mpolci/devhub/README.md

# devhub — hub USB "intelligente" per lo sviluppo hardware

Hub USB da banco pensato per chi sviluppa dispositivi a microcontrollore collegati via USB.
Oltre alle porte downstream espone all'host un **dispositivo di controllo** (USB HID) con cui
il PC può:

- **staccare e riattaccare fisicamente** ogni porta (alimentazione VBUS e linee dati D+/D-),
  per resettare un dispositivo bloccato anche quando il reset via USB non funziona;
- **leggere lo stato** di ogni porta (abilitata/disabilitata, ciclo in corso, guasti hardware);
- **comandare un relè ausiliario** con uscita su due boccole a banana (es. per sezionare
  l'alimentazione esterna del dispositivo in prova o chiudere un contatto di reset).

## Caratteristiche previste (v1)

| Voce | Scelta v1 |
|---|---|
| Porte downstream | 4 × USB-C |
| Velocità | USB 2.0 Hi-Speed (480 Mbit/s) |
| Alimentazione per porta | 5 V, fino a 2 A sulla singola porta USB-C, circa 2,4 A totali stimati, con limitazione di corrente e sezionamento per porta |
| Sezionamento | VBUS **e** D+/D− con unico comando logico; ammessa la sequenza interna del controller |
| Ciclo di spegnimento/riaccensione porta | Ciclo temporizzato con scarica attiva, durata configurabile; default indicativo 1 s da validare, senza verifica della tensione |
| Indicazione porta | Un LED dal MCU: spento, acceso fisso, lampeggiante per guasto |
| Alimentazione hub | richiesti alimentatore USB-C 5 V / 3 A senza negoziazione PD e cavo adeguato; nessuna verifica delle CC |
| Upstream (verso il PC) | USB-C (USB 2.0) |
| Controllo | STM32G0B1 su porta interna dell'hub, interfaccia USB HID senza driver + CLI Python |
| Relè ausiliari | 1 × SPDT su due boccole a banana COM/NC, contatti max 16 V / 3 A |
| Misure | Corrente e carica erogata per porta, temperatura del controllo; nessuna tensione |
| Pannello | 5 pulsanti; 5 LED: uno per porta USB, con lampeggio guasti, e uno di host collegato |

I 3 A d'ingresso comprendono anche i consumi interni: un sovraccarico complessivo può
interrompere l'intero hub. Il ciclo non verifica elettricamente lo spegnimento e riguarda
l'alimentazione fornita dalla porta; per riavviare schede autoalimentate servono relè o reset.

Le motivazioni delle scelte (in particolare USB 2.0 invece di USB 3 e il non sezionare GND)
sono in [docs/architettura.md](docs/architettura.md).

## Struttura del repository

```
docs/        requisiti, architettura, protocollo di controllo, domande aperte
hardware/    progetto KiCad (schema, PCB, BOM)
firmware/    firmware del MCU di controllo
host/        libreria Python e strumento da riga di comando per il PC, skill per agenti AI
```

## Documenti

- [docs/requisiti.md](docs/requisiti.md) — cosa deve fare il dispositivo
- [docs/architettura.md](docs/architettura.md) — schema a blocchi, scelte progettuali, componenti candidati, bilancio di potenza
- [docs/componenti.md](docs/componenti.md) — componenti candidati, package, fornitori, classe JLCPCB
- [docs/protocollo-controllo.md](docs/protocollo-controllo.md) — bozza del protocollo HID tra PC e hub
- [docs/regole-pcb.md](docs/regole-pcb.md) — stackup, piste, USB, alimentazione, piazzamento e verifiche di produzione
- [docs/pinout-mcu.md](docs/pinout-mcu.md) — piedinatura del MCU e note per il firmware
- [docs/domande-aperte.md](docs/domande-aperte.md) — decisioni ancora da prendere

## Licenze

- **Hardware** (`hardware/`): [CERN-OHL-W 2.0](hardware/LICENSE).
- **Firmware, libreria e CLI, documentazione** (tutto il resto): [MIT](LICENSE).

## Stato

Requisiti semplificati definiti (D60–D66). Hub USB2517I-JZX, MCU STM32G0B1CEU6 in UFQFPN48
(D78), due UCS2114-1-V/LX con due bus I²C e quattro PI3USB4002A per le porte (D75), con
DigiKey come fornitore di riferimento.

Schema elettrico v0.3 allineato ai requisiti (D79–D83); PCB 100 × 100 mm a quattro strati (D84)
completo (D84–D95, vedi [hardware/README.md](hardware/README.md)). Il prototipo Rev A è
montato e funziona: corretti alcuni difetti di saldatura, nessuna modifica al PCB.

Firmware ([firmware/README.md](firmware/README.md)) e libreria Python con CLI
([host/README.md](host/README.md)) sono scritti secondo D96–D103 e il protocollo 0.1. Sul
prototipo sono verificati hub configurato via SMBus, aggiornamento via DFU attraverso il
hub, le quattro porte (accensione, spegnimento, ciclo, enumerazione di un dispositivo),
relè, LED, pulsanti, default in flash, eventi, watchdog, temperatura del MCU e corrente delle porte. Restano le misure con strumenti:
durata della scarica e del ciclo, sfasamento delle accensioni, guasti reali e ritorno di
alimentazione (D98), tempi I²C, corrente dei LED, transitori al reset e in DFU. Dopo le misure
il protocollo passerà alla versione 1.0.
