mpolci/devhub/docs/domande-aperte.md

# Decisioni e domande aperte

## Decise

Le decisioni D60–D66 e D68–D87 definiscono i requisiti correnti e prevalgono sulle parti
incompatibili delle decisioni precedenti. Lo schema v0.3 e il pinout le applicano (D79);
il PCB da 100 × 100 mm (D84) è sbrogliato.

| # | Decisione | Scelta |
|---|---|---|
| D1 | Velocità | USB 2.0 Hi-Speed |
| D2 | Sezionamento | VBUS + D+/D- a stato solido; GND mai interrotta |
| D3 | Relè ausiliari | 2 canali, contatti max 16 V / 3 A, bobina 5 V; relè SPDT da 5–10 A, sul pannello **COM e NC** (2 boccole per canale): linea normalmente collegata, bobina eccitata solo per staccare; NO su ponticello a saldare interno |
| D4 | Misura corrente per porta | sì |
| D5 | Pulsanti fisici per porta | sì, uno per porta, più LED |
| D6 | MCU | STM32: **STM32G0B1RET6** (LQFP-64, USB FS + UCPD) |
| D7 | PCB e assemblaggio | JLCPCB 4 strati; **strategia C**: montaggio tutto a mano con piastra riscaldante e aria calda (stencil per i QFN), componenti da un unico fornitore; nessun tipo extended |
| D8 | Alimentazione | USB-C a **5 V / 3 A senza PD**; ~2,3 A totali per le porte, 2 A su una singola porta; budget letto da CC e gestito dal firmware con le misure di corrente |
| D9 | Upstream verso il PC | connettore USB-C |
| D10 | Strumento host | libreria Python generica (multipiattaforma via `hidapi`) + CLI per macOS costruita sopra |
| D11 | Fornitore | si decide alla fine, a componenti finalizzati |
| D12 | Licenze | hardware **CERN-OHL-W 2.0**; firmware, libreria e CLI **MIT** |
| D13 | VID/PID USB | VID 0x1209 (pid.codes) con PID di test durante lo sviluppo; PID definitivo da richiedere a pid.codes alla pubblicazione |
| D14 | Porta hub di scorta (DS7) — superata da D76 | Header eliminato; nessuna uscita USB di scorta. |
| D15 | Scatola | stampata in 3D su misura; tutti i connettori saldati sul PCB, boccole a banana in versione da PCB; connettori sui due lati corti (banco: porte, pulsanti, boccole; retro: upstream e alimentazione); pulsanti e LED  sulla faccia superiore del PCB (D42) |
| D16 | Reset del hub | supervisore **MCP120T-300** open-drain su RESET_N con pull-up, in wired-OR con il MCU (open-drain, ora su PF1: D34): il hub non dipende dal firmware e resta acceso durante reset e DFU del MCU |
| D17 | Regolatore 3,3 V | LDO **AP7361C-33E** (1 A, SOT-223) al posto dell'AP2112K in SOT-23-5 |
| D18 | Connettori USB | orizzontali (angolo retto, montati sopra il PCB): **GCT USB4105-GF-A** per tutti e sei gli USB-C (16 pin USB 2.0, 5 A, guscio con linguette passanti), **Kycon KUSBX-AS1N-B** passante per l'USB-A; scartati i modelli ruotati di 90° (rari e meno robusti) |
| D19 | Quarzo del hub | YXC **X322524MOB4SI** (24 MHz, 3225, C_L 12 pF, il più economico e con più disponibilità), C22/C23 = 15 pF C0G |
| D20 | Condensatori d'ingresso | invariati (2 × 220 µF + 2 × 10 µF): il picco all'inserzione lo elimina l'avvio dolce dell'eFuse |
| D21 | Protezione d'ingresso — soglie precisate da D85 | eFuse **TPS259470A**: stacca sopra 5,84 V e sotto 4,0 V, limite 3,5 A, avvio dolce ~5 ms, FLT al MCU (PB1) |
| D22 | Switch dati delle porte | **PI3USB4002A** al posto del TS3USB30E: il lato connettore regge 24 V e si apre sopra 4,75 V (corti D+/D- su VBUS) |
| D23 | Fornitore — precisata da D77 | DigiKey è il fornitore di riferimento; alternative in `componenti.md`. |
| D24 | LED per porta | due: alimentata (verde) e fault (rosso); lo stato delle linee dati non ha un LED |
| D25 | TVS | sull'ingresso **SMAJ20A** (non conduce fino a 20 V, l'eFuse gestisce le sovratensioni); sulle VBUS delle porte nessuna TVS e nessuna piazzola: bastano i 22 µF + 100 nF |
| D26 | Pulsanti | uno per porta e uno per relè (SW1/SW2 aggiunti); ogni pressione alterna lo stato: porta accesa/spenta con alimentazione e dati sempre insieme, linea del relè collegata/staccata (RF-17) |
| D27 | ESD delle porte downstream | tolte le USBLC6-2SC6 (D101-D501): il loro pin VBUS sulla VBUS commutata faceva passare corrente dai dati all'alimentazione della porta e portava le sovratensioni dei dati verso la 5 V; la protezione ESD è quella integrata nel PI3USB4002A (10 kV IEC, invece dei 15 kV dell'USBLC6). Revisione 02, rilievo R02-01 |
| D28 | Comando delle porte | alimentazione e dati sempre insieme (RF-3 cambiato): niente comandi separati per VBUS e dati né da PC né da pulsante; restano due interruttori distinti per poter rispettare la sequenza |
| D29 | Rilevamento dell'inserimento sulle porte USB-C | non fatto (opzione C, revisione 02, R02-02): VBUS presente appena la porta è accesa; il firmware non accende una porta con tensione già presente e spegne una porta che riceve corrente, con LED rosso e avviso al PC. Scartati un controller USB-C per porta (TPS25810) e la lettura delle CC dal MCU (richiedeva tutti i pin liberi e lasciava senza alimentazione le schede prive di resistenze CC) |
| D30 | Corrente annunciata dalle porte USB-C | standard USB (Rp 56 kΩ, 500 mA) al posto di 1,5 A (revisione 02, R02-03): annuncio coerente con il budget; la porta non lo impone, chi lo ignora assorbe fino a ~2,3 A |
| D31 | Limiti della protezione d'ingresso | protezione garantita in continuo fino a 20 V; sopra ~23 V la SMAJ20A si sacrifica e l'INA3221 (26 V) non è garantito (superato da D40: l'INA3221 non è più sulla catena d'ingresso); TVS invariata, codice fissato in `componenti.md` (revisione 02, R02-04) |
| D32 | Alimentazione della logica | RF-16 eliminato: hub e MCU solo dall'alimentatore, tolto D3 (ORing dalla VBUS upstream), D2 resta per la dissipazione dell'LDO; VBUS_DET e VSYS_ADC su pin FT (PA6, PA7; poi PB2, PB0 con D34) perché il partitore VBUS_DET ha tensione anche a MCU spento; con sovratensione o sottotensione d'ingresso si spegne tutto senza segnalazione al PC; hub funzionante dal solo PC rimandato come variante futura (revisione 02, R02-05) |
| D33 | Driver dei relè | **ULN2003V12** al posto del ULN2003A (stessa piedinatura, uscite MOSFET), tre canali in parallelo per relè: caduta ~0,2 V invece di 0,9–1,1 V, scatto garantito fino a 5V_SYS = 4,5 V e 40 °C; alternativa 2× AO3400A (revisione 02, R02-06) |
| D34 | Pin del MCU, UCPD e bootloader | HUB_RST_N da PA8 (pin CC dell'UCPD, pull-down Rd dopo ogni reset) a PF1; spostati VBUS_DET (PB2), VSYS_ADC (PB0), INA_ALERT (PC12), RLY1/RLY2 (PA4/PA5), EN_P4 (PA7) perché nel bootloader ST relè e porte restino a riposo e il hub funzioni; DBCC dell'UCPD1 a massa con 10 kΩ (R48, R49); il firmware stacca le Rd con UCPDx_STROBE; DFU da provare sul prototipo (revisione 02, R02-07) |
| D35 | Reset del solo hub | gestito dal firmware senza modifiche hardware: lettura di HUB_RST_N ogni ≤10 ms, presa del reset con PF1, rilascio con I2C fermo e configurazione SMBus dopo il rilascio effettivo di U12; brownout reset del MCU non usato perché lascerebbe una finestra 2,8-3,0 V (revisione 02, R02-08) |
| D36 | Accuratezza della misura di corrente | shunt 20 mΩ invariati; RF-6 specifica ±(2 mA + 1,3 % della lettura) (superato da D55: 5 %) con l'azzeramento dell'offset a porta spenta (firmware); collegamenti Kelvin sugli shunt nel PCB; 50 mΩ scartati per la caduta sulla VBUS (revisione 02, R02-09) |
| D37 | Durata della scarica VBUS | non più 100 ms fissi: DIS on finché la VBUS misurata scende sotto 0,8 V (vSafe0V) più ~50 ms, timeout 1 s con porta spenta e PORT_FAULT "sorgente esterna" (protegge anche la 100 Ω, al massimo con 5 V); `off_ms` di CYCLE_PORT contato da VBUS sotto 0,8 V; stessa soglia per il controllo prima dell'accensione (revisione 02, R02-10) |
| D38 | Pilotaggio dei LED | tolti i due 74HC595 (con C90, C91 e il pull-up di /OE R94): verde di ogni porta sull'EN, LED dei relè sui comandi RLY, "acceso" sulla 3,3 V, rossi e host su 6 GPIO (PB3, PB4, PB5, PD0, PB15, PA8) spenti in DFU; i verdi non lampeggiano più, i casi si distinguono con lampeggi del rosso; con il PCB a 4 strati le piste in più non pesano |
| D39 | Condensatori dei pulsanti | tenuti i 100 nF sui 7 pulsanti: toglierli fa risparmiare solo 7 posizionamenti e riduce il margine contro disturbi e scariche sulle linee che arrivano al pannello; il debounce resta in firmware |
| D40 | Shunt d'ingresso dopo l'eFuse | R5 tra l'uscita dell'eFuse e tutti i carichi: il canale 3 dell'INA3221 misura corrente totale e 5V_SYS e non è più esposto alla tensione dell'alimentatore; tolti R7 e C7 e il partitore VSYS_ADC (PB0 libero); LOCAL_PWR con pull-up R26 da 10 kΩ verso la 3,3 V; persa solo la tensione a monte dell'eFuse, inutile dopo D32 |
| D41 | Condensatore sul reset del hub | C24 (100 nF su HUB_RST_N) DNP: il ritardo di 150-700 ms è interno al MCP120 e Microchip non mette condensatori sull'uscita; resta la piazzola per montarlo (anche 1 nF) se compaiono reset spuri; evita anche il picco di scarica su PF1 |
| D42 | PCB e vincoli della scatola | PCB 169 × 85 mm (172,5 × 85 con D59), angoli raggiati R3, 4 fori M3 a 4,5 mm dai bordi; **faccia superiore: solo LED e pulsanti** (premuti e visti dal coperchio), **faccia inferiore: tutto il resto**, connettori compresi; fronte da sinistra (vista dall'alto): porte 1-4 USB-C a passo 15 mm, USB-A a 20 mm dalla porta 4, poi le boccole a coppie (COM/NC dello stesso relè) a 17 mm tra le boccole di una coppia e 20 mm tra USB-A e prima coppia e tra le due coppie; facce dei connettori USB a filo del bordo del PCB, che sta sulla faccia interna della parete frontale; boccole a filo della faccia esterna: la S16N-PC non ha filetto né dado, davanti al corpo c'è un manicotto isolante fisso di 14,35 mm che attraversa il pannello, quindi il corpo è 11,85 mm dentro il PCB e la parete va ispessita intorno alle boccole fino a 14,35 mm (con parete da 2,5 mm); LED e pulsanti come in D43; retro: upstream J2 a 40 mm e alimentazione J1 a 110 mm dal bordo sinistro (disposizione del fronte e del retro superata da D51; passi, distanze e vincoli meccanici invariati) |
| D43 | LED e pulsanti sulla faccia superiore | pulsanti **SMD C&K PTS645SL70SMTR92 LFS** (6×6, attuatore 7 mm, footprint `SW_SPST_PTS645Sx43SMTR92` comune alla serie) al posto dei THT da 13 mm, in fila a 36 mm dal bordo frontale, in asse con ogni porta e al centro di ogni coppia di boccole; LED di ogni porta in colonna, verde a 2 mm e rosso a 6 mm dal bordo frontale; LED dei relè (D90, D91) verdi invece che gialli, nella fila dei verdi; LED acceso (D92) e host (D93) in colonna all'estrema destra (u = 165,5 mm con D59), centrati sulla fila dei pulsanti |
| D44 | Stackup PCB | **JLC04161H-7628**, come nel documento delle regole di prog-board-native: 4 layer, 1,6 mm nominali, rame esterno 1 oz e interno 0,5 oz; prepreg 0,2104 mm per lato e core 1,065 mm. Il modello generico salvato nel PCB di riferimento non si applica. Geometria USB confermata dal calcolatore JLCPCB: 90 Ω differenziali, larghezza 0,2474 mm / gap 0,1519 mm, coppia non coplanare con solder mask su B.Cu e riferimento GND In2.Cu; controllo e tolleranza produttivi da confermare nell’ordine; dettagli in [regole-pcb.md](regole-pcb.md). |
| D45 | Componenti da magazzino e codici fornitore — C3/C4 superati da D86 | si usano i pezzi a magazzino comprati da LCSC, TME, Mouser o DigiKey (non AliExpress), anche cambiando package ma senza passare a 0402 (salvo i 100 nF di U2 e U12, D58, e quelli del MCU U3, D88): C106-C506 in 0603, F1 PTC MF-MSMF050-2 in 1812, C3/C4 Man Yue EGT 220 µF 25 V D6,3 passo 2,5 mm, C505 Panasonic EEE-FK1C101P 6,3 × 5,8 mm; D2 = Diodes B340A-13-F; campi `warehouse`, `lcsc`, `mouser`, `digikey` su tutti i simboli; costi in [confronto-costi.md](confronto-costi.md) |
| D46 | Piazzamento condensatori dei pulsanti | i sette condensatori da 100 nF vanno sulla faccia inferiore vicino ai rispettivi GPIO del MCU, con pista condensatore → pin corta e via GND presso il pad di massa; linee dei pulsanti sopra GND e lontane da bobine e loop di potenza. Il debounce resta in firmware (D39); dettagli in [regole-pcb.md](regole-pcb.md). |
| D47 | Piazzamento dei componenti di supporto | integrati piazzati insieme a disaccoppiamenti, REF, bias e reti di regolazione; capacità VBUS presso le porte, filtri CC R3/C1 e R4/C2 presso il MCU, scarica raggruppata per porta e separazione termica dei circuiti di misura. Distanza connettore–PI3USB4002A da verificare conciliando ESD e integrità USB; per U13 valgono anche le prescrizioni specifiche TPS25947, con collegamenti locali IN/OUT verificati per almeno 6 A e capacità parassita ILM < 50 pF; regole operative in [regole-pcb.md](regole-pcb.md). |
| D48 | Bypass sull'uscita dell'eFuse | C7, 1 µF 25 V X7R 0603 (lo stesso di C106, magazzino ID 240), da 5V_EFUSE a GND presso il pin OUT di U13, prima dello shunt R5: è il ceramico ≥ 1 µF presso OUT richiesto dal datasheet TPS25947 (§8.3.1 e §8.4.1); C3–C6 sono dopo R5 e non lo sostituiscono. Nessuno Schottky di clamp su OUT: l'uscita non va a un connettore né a carichi induttivi, ma solo ai condensatori di riserva sulla scheda attraverso R5 e ai load switch delle porte, che limitano per conto loro; per lo stesso motivo non serve la TVS OUT–IN prevista per le uscite USB-C |
| D49 | Nomi delle coppie USB | suffissi `DP` / `DN`, con numero finale ammesso, perché KiCad riconosca le coppie differenziali (router, gap, skew): `HUB_DP1…5` / `HUB_DN1…5`, `USB_MCU_DP` / `USB_MCU_DN`, `USBUP_DP` / `USBUP_DN`, `SPARE_DP` / `SPARE_DN`, lato connettore `CONN_DP` / `CONN_DN` nei fogli porta e `UP_CONN_DP` / `UP_CONN_DN` sull'upstream; i nomi dei pin dei simboli restano quelli del costruttore |
| D50 | Via termiche del USB2517 | impronta di progetto `QFN-64-1EP_9x9mm_P0.5mm_EP4.7x4.7mm_ThermalVias_0.3mm`, derivata da quella KiCad: 16 via 0,60/0,30 (erano 0,50/0,20), le esterne a ±2,05 mm per restare nel pad esposto da 4,7 mm, nei valori di Microchip AN18.15 (foro 0,25–0,30, pad 0,5–0,6, passo 0,8–1,5, almeno 16 via). Via **aperte su entrambi i lati**, sul lato opposto con apertura della maschera uguale al pad (1:1, ammessa da JLCPCB): nessuna richiesta particolare al fabbricante. Le via "encroached" preferite da Microchip (apertura = foro + 0,06) sarebbero aperture più piccole del pad, che JLCPCB allarga se non lo si chiede nell'ordine; le via coperte intrappolano gas e quelle riempite si pagano a parte sui 4 strati. Rischio accettato per il prototipo: un po' di stagno può scendere nei fori e ridurre la saldatura sotto U2, che dissipa fino a ~1,5 W; da verificare con la temperatura di U2 a 7 porte Hi-Speed. **Per la produzione** l'apertura sul lato opposto va ristretta a via "encroached" (diametro foro + 0,06, cioè 0,36 con `solder_mask_margin` −0,12, Figura 3 di AN18.15) e l'ordine JLCPCB deve contenere la nota nel "PCB Remark" e la conferma dei file di produzione, come descritto in [regole-pcb.md](regole-pcb.md#verifiche-prima-della-produzione) |
| D51 | Disposizione dei connettori | fronte specchiato rispetto a D42 (vista dall'alto, da sinistra): boccole COM1, NC1, COM2, NC2 a u = 17,5, 34,5, 54,5, 71,5 mm, USB-A (porta 5) a u = 91,5 mm, USB-C porte 4, 3, 2, 1 a u = 111,5, 126,5, 141,5, 156,5 mm (u dal bordo sinistro dopo D59), con la porta 1 all'estrema destra; passi e distanze di D42 invariati. Retro: alimentazione J1 a u = 53,5 mm (sinistra), upstream J2 a u = 138,5 mm (destra). Il USB2517 è sulla faccia inferiore: visto dall'alto le sue porte 1→5 girano in senso orario e le coppie arrivano sul fronte da destra verso sinistra, quindi con la porta 1 a destra le cinque coppie non si incrociano e restano su B.Cu senza via; J2 sopra il hub accorcia l'upstream. LED e pulsanti seguono la propria porta o coppia di boccole come in D43, D92/D93 restano a u = 165,5 mm |
| D52 | Polarità delle coppie USB fra componenti sulla faccia inferiore — realizzazione dell'incrocio superata da D94 | canali dell'USBLC6 D20 scambiati: UP_CONN_DN/USBUP_DN su I/O1 (pin 1/6), UP_CONN_DP/USBUP_DP su I/O2 (pin 3/4); con l'assegnazione precedente D+ e D− si sarebbero incrociati fra J2 e D20, il componente è simmetrico. La coppia Full-Speed hub → MCU (USB_MCU_DP/DN) si incrocia comunque, perché i due integrati specchiati numerano i pin nello stesso verso: USB_MCU_DN passa su F.Cu con due via e USB_MCU_DP gira attorno alle via su B.Cu; ammesso a 12 Mbit/s, da non replicare sulle coppie Hi-Speed |
| D53 | VBUS_DET del hub a logica spenta | partitore R22/R23 100 kΩ + 100 kΩ dalla VBUS upstream, senza altri componenti: è il circuito raccomandato dalla *USB2517 Hardware Design Checklist* di Microchip (sezione 5.1), che prevede esplicitamente la VBUS presente prima che l'hub sia alimentato e chiede solo un'impedenza alta per limitare la corrente nel pin (qualche decina di µA con 100 kΩ). Il datasheet (tabella 8.2) indica come limite di funzionamento degli I/O la 3,3 V + 0,5 V quando l'alimentazione è sotto 3,0 V: si segue la checklist, più specifica per questo pin. Scartato lo Schottky verso la 3,3 V proposto con la revisione 03 (R03-02): componente in più per un caso già coperto dal costruttore. La VBUS upstream ha 4,7 µF (C20), sotto i 10 µF massimi della checklist |
| D54 | Corrente della porta USB-A | il connettore Kycon KUSBX-AS1N-B (J501) è da 1,5 A, come quasi tutti gli USB-A 2.0 passanti, e 1,5 A è anche il massimo previsto dalla ricarica USB standard sul Type-A (BC1.2): RF-5 chiede 2 A solo sulle USB-C e 1,5 A sulla USB-A. R62 (ILIM di U6, che serve solo la porta 5) da 24,3 kΩ a **33,2 kΩ 1 %**: limite 1,52–1,85 A dalle formule del datasheet TPS2561A, quindi 1,5 A garantiti; sopra 1,5 A solo durante un sovraccarico, che il firmware vede anche dall'INA3221. Scartato il connettore da 2 A (Würth 614004184726): impronta diversa e margine comunque scarso rispetto ai 2,5 A del limite (revisione 03, R03-03) |
| D55 | Accuratezza RF-6 e shunt | shunt Yageo RL2512FK-070R02L (film spesso) invariati, RF-6 portato a ±(2 mA + 5 % della lettura): per 18–47 mΩ il TCR è ±1200 ppm/°C, che su ~25 °C fra ambiente e autoriscaldamento vale ~3 %, più 1 % di tolleranza e 0,25 % di guadagno dell'INA3221 (~4,3 %); l'azzeramento a porta spenta toglie l'offset, non l'errore di guadagno. Basta per vedere quanto assorbe un dispositivo e accorgersi dei sovraccarichi. Scartati gli shunt in lega a basso TCR (Vishay WSL2512R0200FEA, RALEC LR2512-22R020F4): costo maggiore senza un bisogno reale (revisione 03, R03-04) |
| D56 | Dissipazione dell'LDO U1 | AP7361C-33E confermato (ora variante ER, D91): nel caso peggiore (5,25–5,5 V dall'alimentatore, ~0,5 A sulla 3,3 V con 7 porte Hi-Speed) dissipa 0,8–0,9 W, che con la piazzola minima (110 °C/W) porterebbe la giunzione a ~140 °C a 40 °C ambiente. Il tab (GND) diventa dissipatore: zona GND `U1_HEATSINK` su B.Cu (~1,4 cm²) e 10 via verso il piano GND In2.Cu, per θJA ≤ ~60 °C/W e ≤ ~95 °C di giunzione; temperatura da misurare sul prototipo. Scartato un buck: dalla 5 V risparmierebbe ~0,1 A (0,37 invece di 0,5 A nel caso peggiore), non abbastanza per il costo, il rumore vicino al hub e il rifacimento dell'alimentazione (revisione 03) |
| D57 | Disaccoppiamento del MCU U3 | come da DS13560 figura 15: C41 100 nF + C40 4,7 µF sulla coppia VDD/VSS (pin 6/7), C41 il più vicino; C42 100 nF su VREF+ (pin 5); VBAT (pin 4) collegato a VDD senza condensatore. Tolti C43 e C44 (100 nF senza destinazione, venivano dallo schema generato all'inizio) e C45 (1 µF su VREF+, richiesto solo con VREFBUF, che non si usa). Nello schema ogni condensatore è disegnato sul filo del pin che serve |
| D58 | Disaccoppiamento del hub U2 | secondo la *USB2517 Hardware Design Checklist* di Microchip (DS00004211A, 2021, sezione 3.0): un 100 nF per ciascuno dei 7 pin a 3,3 V (C27 pin 46, C25 pin 5, C38 pin 10, C28 pin 52, C26 pin 57, C30 pin 64, C29 pin 24), un 1 µF condiviso dai quattro VDDA33 (C31, disegnato sul pin 57), 1 µF + 100 nF su VDD33CR (C32 + C29) e solo 1 µF sulle uscite dei regolatori interni VDD18 (C33) e VDD18PLL (C35), che non alimentano altro. Tolti i 100 nF su VDD18 e VDD18PLL della scheda di valutazione EVB-USB2517 del 2008; aggiunto C38, perché i 100 nF erano 6 per 7 pin. C37 è il 100 nF del supervisore U12. Nello schema ogni condensatore è sul filo del proprio pin. I 100 nF di U2 e C37 sono **0402** (magazzino ID 217, Yageo CC0402KRX7R7BB104), eccezione a D45: in 0603 non entrano accanto ai pin fra le coppie USB; la checklist ammette 0603 o più piccoli. I pin 5, 10 e 57 sono fra coppie USB: il tratto +3V3 pad-condensatore può stare a 0,2 mm dalle coppie dentro l'area di regola `U2_FANOUT` attorno a U2 (regola DRC "USB e piste vicine a U2"), invece delle 0,75 mm generali; niente via fra pad e condensatore |
| D59 | Margini laterali del PCB | profilo allargato di 3,5 mm a sinistra: **172,5 × 85 mm** (era 169 × 85), così il margine fra il bordo e il corpo del connettore più esterno è uguale sui due lati del fronte: 11,45 mm dal bordo sinistro alla boccola J5 e 11,48 mm dal bordo destro alla USB-C J101 (corpo sullo strato Fab). Spostati anche i fori M3 di sinistra (H1, H3), sempre a 4,5 mm dai bordi, e il piano GND di In2; tutte le quote u dal bordo sinistro aumentano di 3,5 mm |
| D60 | Eliminazione delle misure — corrente e carica per porta reintrodotte da D103 | RF-6 eliminato: nessuna misura di corrente delle cinque porte o totale, né lettura di tensione delle porte/5V_SYS. Da rimuovere U7/U8 INA3221, i sei shunt R5/R65–R69 e i supporti dedicati; niente partitori sostitutivi sulle porte. Supera D4, D36, D55 e la parte di D40 relativa alle misure. Il rilevamento VBUS upstream per l'hub resta. Nessuna diagnosi firmware di sorgente esterna o corrente inversa tramite misure (supera quella parte di D29); restano le protezioni hardware. |
| D61 | Ciclo temporizzato e scarica | RF-2/RF-4: scarica attiva richiesta, ma nessuna verifica di VBUS sotto 0,8 V. Tempo configurabile dal comando di disabilitazione VBUS, comprensivo della scarica; default indicativo 1 s da validare sul circuito e sul prototipo. Durata della scarica e limiti configurabili devono rispettare i limiti termici, anche con sorgente esterna o porta lasciata spenta. Il completamento del ciclo non certifica lo spegnimento o il riavvio del dispositivo. Capacità elevate possono richiedere più tempo; le schede autoalimentate richiedono relè/reset per il riavvio. Supera D37. |
| D62 | Sequenza interna delle porte | RF-3: un unico comando logico per VBUS e D+/D−; ammessi ordine e tempi interni del controller, purché a porta disabilitata alimentazione e dati siano interrotti anche con dispositivi autoalimentati. Nessun ritardo dati/VBUS regolabile e nessun parametro `on_delay_ms`. Resta configurabile la durata complessiva dello spegnimento. Supera il vincolo di sequenza separata di D28; controller da scegliere. |
| D63 | Un LED per porta USB | RNF-5: un LED pilotato dal MCU, spento = disabilitata, fisso = abilitata, lampeggiante = guasto (prioritario); dettaglio hardware dal PC. Indica lo stato logico, non VBUS misurata. Da eliminare cinque LED e cinque resistenze; riferimenti, colore e posizione del LED mantenuto da definire nello schema/PCB. Pulsanti, LED dei relè, alimentazione e host invariati. Supera D24 e le parti relative ai LED USB di D38/D43. |
| D64 | Gestione dei guasti senza budget misurato — budget dinamico introdotto da D105 | RF-15: accensioni sfalsate e gestione dei guasti hardware; niente calcolo dei consumi, budget configurabile o selezione della porta più energivora. Restano i limitatori per porta e le protezioni d'ingresso. Un sovraccarico complessivo può spegnere l'intero hub; nessuna garanzia di continuità delle altre porte. Supera la gestione dinamica di D8. |
| D65 | Alimentatore fisso e nessuna verifica CC | RF-13 richiede alimentatore USB-C 5 V / 3 A senza PD e cavo adeguato, a carico dell'utilizzatore. Un alimentatore PD è ammesso solo se offre anche questa modalità; capacità inferiori non garantite. RF-14 eliminato: nessuna lettura CC né controllo dell'annuncio di 3 A. Restano Rd da 5,1 kΩ e protezioni hardware; da togliere collegamenti all'ADC e filtri dedicati R3/R4/C1/C2. I 3 A comprendono tutti i consumi; ~2,3 A alle porte è una stima da rivalutare. Supera lettura CC e adattamento all'alimentatore di D8. |
| D66 | Quattro USB-C e un solo canale ausiliario | Eliminata la porta USB-A con alimentazione, dati, scarica, protezioni e comandi dedicati. Restano quattro USB-C e un solo relè SPDT con due boccole COM/NC, un pulsante e un LED; NO sul ponticello interno come in D3. Cinque pulsanti complessivi e sette LED (quattro USB, relè, alimentazione, host). Supera il numero di canali di D3, la USB-A di D18/D54 e i conteggi/disposizioni incompatibili di D26/D38/D42/D43/D51/D63. USB HID interno e header di scorta D14 restano; la DS5 liberata non diventa una nuova uscita. Schema, PCB, pinout e BOM sono da adeguare dopo la scelta degli integrati. |
| D67 | Valutazione senza MCU e pulsanti — non adottata (D68) | Sono accettati per la variante in valutazione cicli e impulsi gestiti dal PC e la rimozione dei pulsanti. Approfondire USB4715/HFC come sostituto del controllo STM32, compresi macOS, WinUSB e GPIO. La ricerca propone USB4715 + espansore I²C TCA9535, ancora da collaudare; nessuna nuova selezione hardware definitiva. L’adozione richiederà sostituire HID e autonomia nei requisiti/protocollo, definire i default e rinunciare all’header USB di scorta o scegliere un altro hub. Le specifiche attuali descrivono ancora la base con MCU. |
| D68 | Conferma MCU, controllo autonomo e pannello | Mantenere un hub con MCU separato e USB HID (modello hub da scegliere, D69), cicli e impulsi temporizzati eseguiti dal MCU. STM32G0B1RET6 resta il riferimento; un package più piccolo è valutabile solo dopo la scelta dei controller porta e il conteggio GPIO. Conservare cinque pulsanti (quattro USB e uno relè) e un LED per porta pilotato dal MCU, con lampeggio guasti; sette LED complessivi. Confermati quattro USB-C, un relè con due boccole COM/NC e header interno di scorta. La variante USB4715 senza MCU, con o senza TCA9535, non è adottata: la ricerca resta fra le alternative valutate. Supera l’indirizzo di valutazione D67; nessuna modifica a schema/PCB in questa fase. |
| D69 | Modello del hub non vincolato | USB2517 è il componente dello schema esistente, non un requisito. Scegliere il hub più utile per la soluzione con MCU separato, valutando porte necessarie, supporti esterni, consumi, package, costo, reperibilità e configurazione. Restano i requisiti funzionali confermati; D68 non impone USB2517. |
| D70 | Scarica automatica e semplicità del circuito | La scarica attiva VBUS può attivarsi automaticamente alla disabilitazione della porta, anche integrata nel controller; non sono richiesti GPIO DIS o controllo separato dal MCU. Scegliere la soluzione complessivamente più semplice per componenti, collegamenti e firmware, nel rispetto delle protezioni e dei limiti di scarica D61. Il MCU gestisce il tempo fra spegnimento e riaccensione della porta; non deve necessariamente comandare la scarica. |
| D71 | Permanenza di una scheda alimentata esternamente | Deve essere possibile lasciare collegata indefinitamente una scheda alimentata esternamente senza danneggiare devhub, anche a porta disabilitata e con VBUS sostenuta dalla scheda. La scarica può interrompersi automaticamente: non è richiesta dissipazione continua né controllo DIS dal MCU. Restano blocco inverso e protezioni hardware; ambito della tensione esterna definito da D72. Non implica lo spegnimento della scheda autoalimentata. |
| D72 | Sorgente esterna a 5 V sulla VBUS downstream | La tolleranza continua D71 riguarda sorgenti da 5 V nominali con tolleranza. Non è richiesta protezione della VBUS downstream da 12 o 20 V accidentali; non aggiungere circuiti solo per coprire tali tensioni. Fissare il massimo operativo numerico nel dimensionamento. Restano blocco inverso, limitazione di corrente, ESD e protezione dati già richiesti; la protezione dell’ingresso alimentatore è distinta. |
| D73 | Ripristino manuale dopo guasto porta | Quando riceve un guasto hardware della porta, il MCU interrompe l’eventuale ciclo, disabilita VBUS e dati e mantiene il LED lampeggiante. Nessuna riaccensione automatica alla scomparsa del segnale: serve un tentativo esplicito di riabilitazione da pulsante o PC. Se il guasto persiste o ricompare, la porta torna disabilitata con LED lampeggiante. Non è obbligatorio un controller latch-off: la protezione immediata resta hardware e il blocco persistente può essere gestito dal MCU finché alimentato e operativo. |
| D74 | Stato di fabbrica delle porte | Tutte e quattro le porte abilitate dopo l’avvio del firmware, con accensioni sfalsate per l’inrush. Resta possibile salvare una configurazione diversa per porta. Lo stato durante reset/bootloader è una verifica elettrica distinta. |
| D75 | Controller delle quattro porte — misura corrente e charge rationing usati da D103 | Scelti due UCS2114-1-V/LX, uno per coppia di porte, con due bus I²C indipendenti per il comune indirizzo 0x57; mantenuti quattro PI3USB4002A per i dati. La variante -1A non viene utilizzata perché non reperita. Abilitare e verificare la scarica automatica via I²C all’avvio; 400 ms come impostazione iniziale da validare. Strap 27 kΩ / 1%, enable VBUS e dati separati sotto un comando logico, nessun MOSFET o GPIO DIS esterno. Il firmware mantiene il blocco manuale dei guasti; misura corrente e charge rationing non utilizzati. Schema/PCB da adeguare dopo hub e pinout MCU, verifiche elettriche e collaudo restano necessari. |
| D76 | Eliminazione header USB di scorta | Nessun header USB downstream di scorta. Servono cinque porte fisiche del hub: quattro USB-C e la connessione interna al MCU. Supera D14 e i riferimenti allo header in D66/D68. Con USB2517, DS5 e DS7 sono inutilizzate; eliminare connettore e alimentazione dedicata dallo schema. |
| D77 | Fornitore di riferimento | DigiKey per selezione e confronto dei componenti, verificando codice esatto, acquisto a pezzo singolo e disponibilità effettiva. La presenza a catalogo non implica disponibilità. Supera l’indicazione provvisoria di D23; restano utilizzabili i componenti già a magazzino secondo D45. |
| D78 | Hub e MCU confermati | Scelti USB2517I-JZX e STM32G0B1CEU6, versione GP in UFQFPN48, con DigiKey come riferimento. Due bus I²C indipendenti per gli UCS2114; hub sul primo bus a 0x2C. Nessun header USB di scorta. La selezione chiude il confronto D69 e sostituisce il riferimento MCU a 64 pin di D68. Il pinout a 48 pin è documentato come assegnazione da applicare; l’adeguamento dello schema è a cura dell’utente. |
| D79 | Schema v0.3 | Aggiornato il progetto KiCad esistente invece di rifarlo: restano alimentazione, hub, porte, relè e LED di stato, con i campi fornitore e le impronte già verificati. U3 diventa STM32G0B1CEU6 sul pinout di [pinout-mcu.md](pinout-mcu.md); il foglio switches contiene U4/U5 UCS2114-1-V/LX (COMM_ILIM 27 kΩ 1 %, 100 nF su VDD, 1 µF per coppia di pin VS, BOOST# a massa, ALERT# con pull-up 10 kΩ a 3,3 V verso MCU e OCS1–4_N del hub); pull-up 4,7 kΩ su entrambi i bus I²C (R40/R41, R50/R51). DS5, DS7 e OCS5_N del hub non collegati: con CFG_SEL 001 e 101 gli strap sono disattivati, le porte si disabilitano via SMBus. Eliminati R3/R4/C1/C2, shunt R5 (C7 resta sull'uscita dell'eFuse), INA3221, TPS2561A e shunt delle porte, J3/F1, porta USB-A, scariche discrete, LED rossi, secondo relè; canali 4–6 del ULN2003V12 con ingressi a massa. Impronta UCS2114 di progetto dal land pattern Microchip C04-2421, area termica coperta da solder mask sul pin 17 (GND) |
| D80 | Pull-down degli EN porta | R42–R45 da 10 kΩ invece di 100 kΩ: con la dispersione massima di ±5 µA di PWR_EN dell'UCS2114 la tensione resta sotto 0,05 V invece di 0,5 V, contro VIL 0,8 V; 0,33 mA per porta abilitata |
| D81 | Colore del LED unico di porta | Verde: si tiene il LED che indicava la porta alimentata (D102–D402 con R106–R406, 1 kΩ), pilotato da LED_P1–P4; il guasto si distingue dal lampeggio (D63) |
| D82 | LED di sistema — LED del relè ripristinato da D90 | Dei tre LED di sistema resta solo quello di host collegato (D93, R93, da LED_HOST). Eliminati il LED del relè (D90, R90) e quello di accensione (D92, R92). Cinque LED complessivi: quattro di porta e host. Supera i conteggi dei LED di D66 e D68 |
| D83 | Fogli dello schema | Gli switch VBUS (U4/U5 UCS2114 con strap, disaccoppiamenti e pull-up degli ALERT#) stanno nel foglio del hub, rinominato "Hub USB e switch VBUS"; il LED di host (D93, R93) sta nel foglio MCU, con LED_HOST come etichetta locale. Eliminati i fogli `switches` e `ui`; il relè resta nel proprio foglio. Componenti, riferimenti e collegamenti invariati |
| D84 | PCB 100 × 100 mm — fila dei pulsanti superata da D87, LED host da D90, foro H1 da D95 | Profilo 100 × 100 mm R3, 4 strati. Fronte (vista dall'alto, u dal bordo sinistro): boccole COM/NC a u = 10 e 27 (17 mm fra loro), USB-C porte 4…1 a u = 46, 61, 76, 91 (passo 15 mm, 19 mm fra boccola NC e porta 4), margini laterali ~3,5 mm; pulsanti a v = 36 in asse con porte e coppia di boccole, LED a v = 2, LED host sopra le boccole. Retro: J1 a u = 24, J2 a u = 82. Fori M3 tolti dagli angoli anteriori: H1 (4,5; 58) dietro il relè, H2 (95,5; 28), H3/H4 agli angoli posteriori a 4,5 mm dai bordi. Restano le regole delle facce di D42 (sopra solo LED e pulsanti) e le profondità di boccole e connettori di D42/D43. Supera profilo, posizioni e fori di D42, D51 e D59 |
| D85 | Soglia OVLO dell'eFuse | R30 = 68,1 kΩ e R31 = 8,66 kΩ 1 % (R32 = 20,5 kΩ invariata): OVLO 5,69 V nominali, **5,52–5,90 V** con la tolleranza della soglia (1,183–1,223 V) e delle resistenze, rientro sotto 5,17 V; UVLO 4,00 V in salita (3,89–4,14 V), 3,64 V in discesa. Con 69,8 kΩ / 9,53 kΩ lo stacco arrivava fino a 6,05 V, oltre i 6 V massimi assoluti di VDD, VS e VBUS degli UCS2114 (U4/U5), alimentati direttamente dalla +5V (i TPS2561A reggevano 7 V). Fra 5,5 V, massimo di un alimentatore USB-C, e la soglia OVLO gli UCS2114 sono fuori dal funzionamento specificato (VDD ≤ 5,5 V) ma entro il massimo assoluto: è solo una condizione di guasto transitoria |
| D86 | Condensatori di riserva sulla +5V | C3/C4 SMD **Panasonic EEE-FK1C221XP** (220 µF 16 V, Ø 6,3 × 7,7 mm, impedenza 0,34 Ω, ripple 280 mA a 100 kHz, impronta `Capacitor_SMD:CP_Elec_6.3x7.7`) al posto dei radiali THT Man Yue EGT del magazzino; stessa serie del EEE-FK1C101P a magazzino. Stesso codice su LCSC, Mouser e DigiKey; scartato il EEE-FK1C221P (Ø 8 × 6,2 mm) perché non disponibile su Mouser. Valore invariato (2 × 220 µF + 2 × 10 µF, D20): riserva comune della +5V per accensioni e inserzioni sulle quattro porte, con l'avvio dolce dell'eFuse a ~0,4 A. 16 V per margine sui 5,9 V massimi lasciati passare dall'OVLO (D85). Sulla faccia inferiore, 7,7 mm di altezza invece di 11 mm |
| D87 | Fila dei pulsanti più vicina ai LED | Pulsanti SW1 e SW401…SW101 a **v = 14,5 mm** dal bordo frontale invece di 36, stesse coordinate u (in asse con porte e coppia di boccole): ~12,5 mm fra LED (v = 2) e centro del pulsante invece di 34. Limiti: davanti, le via VBUS delle porte vicino ai connettori (0,3 mm dai pad dei pulsanti delle porte); dietro, i fori di fissaggio delle boccole (0,74 mm dai pad di SW1), che non entra fra le due boccole. Sotto la fila, sulla faccia inferiore, restano switch dati e passivi delle porte; gli estensori del coperchio vanno spostati di conseguenza |
| D88 | Condensatori da 100 nF del MCU U3 in 0402 | C41 (VDD/VDDA), C42 (VREF+) e C46 (NRST) in 0402 (`Capacitor_SMD:C_0402_1005Metric`), stesso pezzo a magazzino dei disaccoppiamenti del hub (ID 217, Yageo CC0402KRX7R7BB104), per stare davanti ai pin del MCU a passo 0,5 mm. C40 (4,7 µF) resta 0603 |
| D89 | Ponticello NC/NO del relè (JP2) | Impronta di progetto `lcsc_footprints:SolderJumper-3_P2.4mm_Bridged12_Pad2.0x3.0mm` al posto di quella KiCad da 1,0 × 1,5 mm con striscia da 0,6 mm, sottodimensionata per 3 A: tre pad 2,0 × 3,0 mm a passo 2,4 mm (0,4 mm fra i pad, sopra gli 0,2 della regola fra reti del contatto), striscia 1-2 da 1,0 mm scoperta dal solder mask, da tagliare per passare a NO con un ponte di stagno 2-3. I pad alti 3 mm accolgono le piste RELAY_CONTACT da 2 mm senza restringimenti |
| D90 | LED del relè | Ripristinato il LED del relè come in v0.2: D90 verde 0805 con R90 1 kΩ dal comando RLY1 (PD2) a GND, nel foglio del relè; acceso con bobina eccitata, cioè linea staccata, senza GPIO in più. D90 sta nella fila dei LED a u = 18,5, v = 2, in asse con SW1 fra le boccole; il LED host D93 sta sul retro a sinistra di J1 (u = 10, v = 90, faccia superiore), con R93 alla sua destra (u = 15). Sei LED complessivi: quattro di porta, relè e host. Supera il LED del relè eliminato da D82 e la posizione del LED host di D84 |
| D91 | Variante dell'LDO U1 | **AP7361C-33ER** (SOT-223R) al posto dell'AP7361C-33E: stesso regolatore, l'unica variante a catalogo Mouser. Piedinatura invertita: pin 1 GND, pin 2 e tab OUT, pin 3 IN; impronta `SOT-223-3_TabPin2` invariata, simbolo `devhub:AP7361C-33ER`. Il datasheet dell'AP7361C (DS37274 Rev. 5-2, `datasheets/ap7361c.pdf`) non indica la rete del tab; quello dell'AP7361 (DS33626 Rev. 11-3, `datasheets/ap7361.pdf`, stessi package) numera il tab del disegno "SOT223/SOT223R" come pin 2, quindi nella variante R è OUT. Il tab è su +3V3: `U1_HEATSINK` diventa una zona +3V3 su B.Cu con le via verso il piano +3V3 In1.Cu invece che verso GND In2.Cu (D56). LCSC C3743528, Mouser 621-AP7361C-33ER-13, DigiKey AP7361C-33ER-13DICT-ND |
| D92 | Test point | 14 test point nello schema, solo per le reti che non hanno già un punto comodo da sondare (SWD, NRST e UART restano su J4 e J9). Due anelli GND Keystone 5001 per la massa della sonda: TP1 nell'alimentazione, TP10 vicino al MCU e al hub; vicino alle porte la massa si prende dai connettori USB-C. Pad SMD da 1,5 mm, fuori BOM: TP2 +5V e TP3 +3V3 (avvio dolce dell'eFuse, rampe e cadute), TP4-TP7 I2C1/I2C2 (fronti e analizzatore logico), TP8 HUB_RST_N (tempo di reset), TP9 EFUSE_FLT_N (prove di guasto), TP11-TP14 VBUS_P1-P4 (scarica e tensione alla porta). Esclusi 5V_LOGIC, FAULT_P1-P4, VBUS_DET e le coppie USB |
| D93 | +5V verso U4/U5 su In1.Cu | Deroga alla distribuzione della +5V sulle facce esterne ([regole-pcb.md](regole-pcb.md#funzione-dei-layer-e-ritorni-di-corrente)): vicino alle porte le facce esterne sono occupate da connettori, switch dati, LED e pulsanti. La +5V esce da U13 su una zona di B.Cu fino a x ≈ 100 mm e prosegue su una zona di In1.Cu lungo il bordo frontale, sotto la fila dei pulsanti, con le risalite fino alle via sotto U4 e U5; sopra la zona non passano coppie USB né il quarzo, il resto di In1.Cu resta piano +3V3. Con la sola pista da 2 mm su In1.Cu (0,5 oz) la caduta da U13 a U4 era di 146 mV a 3 A; con le zone, simulata in continua sul rame reale, è di 40 mV verso U4 e 25 mV verso U5. Nel caso peggiore, da U13 alla porta e ritorno, il solo rame vale ~69 mV per le porte 1–2 e ~54 mV per le porte 3–4 (+5V, VBUS e GND), sotto i 100 mV richiesti; esclusi eFuse, UCS2114 e il tratto J1–U13 |
| D94 | Segnali e salto USB su In1.Cu | Deroga alla tabella dei layer ([regole-pcb.md](regole-pcb.md#funzione-dei-layer-e-ritorni-di-corrente)): In1.Cu resta piano +3V3, ma ospita brevi tratti di segnali lenti dove B.Cu e F.Cu sono occupate: BTN_P1 e BTN_P2 (43 e 46 mm a u ≈ 36, lungo il bordo ovest del piano, che inizia a u = 34,9), I2C1_SDA (6 mm in sei tratti attorno a U2), I2C2_SCL e I2C2_SDA (4 mm fra U3 e U5), FAULT_P3 (2 mm) e RLY1 (8 mm dentro l'area RELAY1_CONTACTS, dove il piano è già escluso). Nessuna isola né strozzatura del piano; nessun tratto sotto coppie USB o quarzo. L'incrocio della coppia Full-Speed (D52) è inevitabile con hub e MCU sulla stessa faccia: la coppia resta su B.Cu e USB_MCU_DP salta su In1.Cu per 3,2 mm con due via, così il piano GND di In2.Cu, riferimento delle coppie, resta continuo. Il DRC conta anche le via (≈1,3 mm ciascuna): la differenza di lunghezza si pareggia su USB_MCU_DN con lo strumento di accordo di KiCad. Supera la realizzazione dell'incrocio descritta in D52 |
| D95 | Fori di montaggio | H1 (M3) a u = 20, v = 44,2 mm, a destra del relè K1 e dentro l'area RELAY1_CONTACTS, invece di (4,5; 58) di D84; H2, H3 e H4 invariati. Tutti e quattro con impronta `MountingHole_3.2mm_M3_Pad`: anello di rame da 6,4 mm su tutti gli strati, senza rete, per l'appoggio di viti e distanziali. Coperchio e distanziali seguono le quote del PCB |
| D96 | Stack e struttura del firmware | **TinyUSB** per l'USB device e HAL di **STM32CubeG0** per clock, GPIO, I²C e flash; nessun RTOS: ciclo principale cooperativo con tick da 1 ms, interrupt ridotti a segnalazioni. Build con CMake e arm-none-eabi-gcc, senza progetto CubeMX. Scartata la libreria USB device di ST: dispositivo composito più laborioso e codice legato a CubeMX. Un solo firmware: il collaudo della scheda è la console diagnostica del firmware definitivo (D97), non un firmware di prova separato |
| D97 | Console diagnostica | Stessa console a comandi di testo, con i log, sulla **UART di J9** (USART2) e su una **CDC USB**: il dispositivo USB del MCU è composito, HID di controllo + CDC. La UART serve quando USB o hub non funzionano; la CDC evita l'adattatore seriale. La console espone i comandi di collaudo delle singole periferiche (GPIO, hub, UCS2114, relè, pulsanti) e resta nel firmware definitivo |
| D98 | Guasti bloccanti e avvisi delle porte | Negli UCS2114 si imposta ALERT_MASK: ALERT# (verso MCU e OCS del hub) si attiva solo per **sovracorrente** e **sovratemperatura**, gli unici guasti che bloccano la porta secondo D73. **Scarica non riuscita**, **tensione di ritorno** e VBUS sotto il minimo sono avvisi: il MCU li legge dai registri, li espone al PC senza bloccare la porta né interrompere il ciclo, e il LED non lampeggia. Una scheda autoalimentata può così restare collegata ed essere sottoposta a cicli (D71). Gestione automatica degli errori del controller lasciata attiva (LATCHS = 0): il blocco persistente è del MCU. Il comportamento dello stato di errore del controller con ALERT# mascherato va verificato sul prototipo |
| D99 | Pulsante durante un ciclo | La pressione del pulsante di una porta con ciclo in corso annulla il ciclo e lascia la porta disabilitata; una nuova pressione la riabilita. Il PC riceve la notifica del cambio di stato. Su una porta bloccata per guasto la pressione è il tentativo esplicito di riabilitazione di D73 |
| D100 | Host scollegato o sospeso | Stato delle porte e del relè invariato quando il PC a monte viene scollegato o sospende il bus; pulsanti sempre attivi. Si spegne solo il LED di host collegato. Nessuno spegnimento né riaccensione automatica delle porte legati alla presenza del PC |
| D101 | Libreria e CLI insieme al firmware | La libreria Python e la CLI di base si sviluppano insieme ai comandi HID del firmware e servono anche per i test automatici sulla scheda; le rifiniture della CLI vengono dopo |
| D102 | Temperatura della scheda | Il firmware legge il sensore di temperatura interno dello STM32G0B1, con le calibrazioni di fabbrica a 30 °C e 130 °C e la correzione della tensione di riferimento tramite VREFINT, e la espone in `GET_STATUS`, nella CLI e nella console. È la temperatura del chip del MCU, al centro della scheda, con precisione di qualche grado: segue la scheda, non i punti caldi. Gli altri chip non hanno una lettura di temperatura: gli UCS2114 hanno solo lo spegnimento termico (120 °C e 135 °C), segnalato come guasto `overtemperature`; USB2517 e TPS259470A nessuna. Non cambia D60: nessuna misura di corrente o tensione esposta |
| D103 | Corrente e carica per porta | Il firmware legge dagli UCS2114 la corrente di ogni porta (registri 00h/01h, passo 13,3 mA, ±2 % sopra 200 mA, ±2 passi sotto) e la carica erogata (registri 16h–1Dh, passo 0,00367 mAh, ±4,5 %, aggiornata ogni secondo) e le espone in `GET_STATUS`, nella CLI e nella console. Per avere la carica il charge rationing è abilitato con comportamento "Ignore" e soglia massima: il controller conta e basta, senza staccare la porta né attivare ALERT#. La carica si azzera con `RESET_CHARGE` e, per le porte scelte con `SET_CHARGE_RESET` (salvato in flash con i default, di fabbrica nessuna), a ogni accensione della porta. Nessun componente aggiunto: supera D60 per la misura di corrente per porta; restano escluse corrente totale e tensioni. Lo zero non è esatto (0–13 mA a porta vuota, qualche mAh all'ora di carica): misura indicativa, non uno strumento |
| D104 | Limite di corrente per porta | Il limite hardware di ogni porta si può abbassare via SMBus (registro 14h dell'UCS2114) ai gradini 0,53, 0,96, 1,07, 1,28, 1,6, 2,13 e 2,67 A; non oltre i 2,67 A fissati dalla resistenza COMM_ILIM. Fino a 1,28 A il controller lavora in corrente costante: oltre il limite tiene la corrente e lascia scendere la VBUS, così gli spunti brevi (condensatori del dispositivo all'accensione o al collegamento a porta già accesa, che l'hardware non permette di rilevare) passano. Il MCU legge ogni 20 ms il bit CC_MODE (registro 02h) e, se la porta resta in limitazione oltre una tolleranza configurabile per porta (20–10000 ms, di fabbrica 100), la spegne e la blocca con causa `current_limit` (D73). Il tetto IBUS_R2MIN (registri 23h/24h) è il gradino successivo (0,53 → 0,96, 0,96 e 1,07 → 1,28, 1,28 → 1,6 A): oltre, il controller stacca da solo; anche una VBUS sotto 2 V su una porta in corrente costante è un guasto `current_limit` e non un avviso (eccezione a D98). Da 1,6 A il controller lavora in Trip (IBUS_R2MIN a 100 mA): stacca dopo circa 6 ms sopra il limite, causa `overcurrent`. Limiti e tolleranze sono impostazioni per porta salvate in flash con i default (di fabbrica 2,67 A e 100 ms) e applicate alla configurazione dei controller e a ogni modifica. Si salva anche la corrente erogabile dall'alimentatore (di fabbrica 3 A): la CLI la confronta con il caso peggiore, cioè la somma dei limiti più 0,48 A di consumi interni. Verificato sul prototipo: ESP32 con limite 0,53 A, nessuno scatto in 10 cicli e in 3 collegamenti a caldo; carico da circa 1,3 A con limite 0,96 A, spegnimento dopo 119 ms con tolleranza 100 ms e dopo 1009 ms con 1 s, anche al collegamento a caldo; riarmo regolare. Il controllo dinamico della corrente totale è in D105 |
| D105 | Controllo dinamico della corrente totale | Ogni 20 ms il firmware somma le correnti delle porte accese (una lettura per controller) e una stima di 0,48 A di consumi interni, e le confronta con la corrente dell'alimentatore salvata (D104, di fabbrica 3 A). Se la somma resta sopra per 50 ms, abbassa il limite della porta che consuma di più al gradino che riporterebbe il totale entro l'alimentatore, minimo 0,53 A: la porta resta accesa con l'avviso `budget`, il suo LED si spegne per 100 ms ogni secondo (diverso dal lampeggio di guasto, eccezione a D98 per gli avvisi) ed è esentata dalla tolleranza di D104, così un dispositivo che si adatta, come un caricatore, continua a funzionare a corrente ridotta. Se quella porta è già a 0,53 A viene spenta e bloccata con causa `budget` (D73). Il limite ridotto non cambia le impostazioni e resta fino alla successiva accensione della porta o a un nuovo limite impostato. Agisce sui sovraccarichi fra la corrente dell'alimentatore e il limite dell'eFuse (3,5 A), quelli che crescono gradualmente; oltre 3,5 A l'eFuse interviene in circa 8 ms e restano i limiti per porta. La reazione dell'alimentatore reale in quella fascia va misurata al banco. Verificato sul prototipo dichiarando un alimentatore più piccolo del carico: riduzione dopo 70 ms, con il dispositivo che si adatta, e spegnimento dopo 66 ms al gradino minimo. Supera D64 e la parte di RF-15 sul budget |
| D106 | Skill per agenti AI | I sorgenti di una skill in formato Agent Skills (`SKILL.md`) stanno in `host/skill-devhub/` e si installano con un link, per esempio in `~/.claude/skills/devhub`. Descrive il comportamento del dispositivo (porte, power cycle e attesa della nuova enumerazione, linea del relè, guasti e avvisi, lettura dello stato) con la CLI e la libreria Python, e lascia all'agente la scelta di quando usarlo; per i dettagli dei comandi rimanda a `devhub help`. L'agente può senza chiedere accendere, spegnere e ciclare qualsiasi porta, anche tutte insieme, e comandare il relè; chiede conferma per nomi delle porte, limiti, default, salvataggio in flash, reset del hub, riavvio e bootloader |

## Aperte

- Dimensionare e validare il circuito scelto D75: due UCS2114-1-V/LX e quattro PI3USB4002A,
  capacità, scarica automatica, guasti, ritorno di alimentazione e stato al reset/bootloader.
- Completare la verifica del pinout a 48 pin sul prototipo. Due I²C, USB HID e CDC, reset
  del hub e ingresso nel bootloader funzionano; la sonda SWD riconosce il MCU. Restano
  programmazione via SWD, UART di J9 e transitori di porte e relè durante reset e DFU.
- Definire durata sicura della scarica, default e intervallo ammesso del ciclo sul circuito
  definitivo; il secondo proposto non è una garanzia per qualsiasi capacità o alimentazione esterna.
- Confermare sul prototipo la gestione dei guasti D98: ALERT# mascherato, lettura della causa
  prima di togliere PWR_EN, uscita dallo stato di errore del controller con tensione di ritorno.
- Validare i tempi fissati nel protocollo: sfasamento fra le accensioni (100 ms), limiti di
  `off_ms` (500–60000 ms) e dell'impulso del relè.
- Misurare al banco, con un carico elettronico, come reagiscono alimentatore ed eFuse a un
  sovraccarico fra 3 e 3,5 A, per confermare che il controllo del totale (D105) fa in tempo.
- Verificare al banco, con un carico elettronico, il tetto dei limiti in corrente costante e lo
  scatto in Trip dei limiti da 1,6 A in su (D104).
- Corrente totale d'ingresso: il pin ILM dell'eFuse U13 dà una tensione proporzionale alla corrente
  (182 µA/A su R33, ±10 %). Leggerla richiede un collegamento a un ingresso ADC libero del MCU
  (per esempio PA6) e la verifica che il carico non alteri il limite di corrente: da valutare per
  la prossima revisione.
- Strumenti host fuori da macOS. Linux: fornire una regola udev per l'accesso al dispositivo HID
  (VID 0x1209, PID 0x0001) senza root. Windows: la ricerca dei dispositivi collegati alle porte
  (`status`, `find`, `@testo`, `--wait`) non è disponibile; scegliere come leggere l'albero USB.
- Modifiche per la prossima revisione della scheda:
  - collegamento del pin ILM dell'eFuse a un ingresso ADC per la corrente totale (voce sopra);
  - NTC vicino a U2 (USB2517), il componente più caldo, che non ha una lettura di temperatura,
    letto da un GPIO libero con ADC;
  - test point sulla rete VBUS_DET, oggi misurabile solo sulle piazzole di R22/R23;
  - LED verdi delle porte D102–D402 molto meno luminosi del LED host D93 a parità di
    resistenza (1 kΩ, circa 1,3 mA da 3,3 V): l'LTST-C171GKT è un GaP da 12 mcd tipici a
    20 mA, l'LTST-C171KFKT arancio un AlInGaP da 90 mcd. Sostituirli con un verde AlInGaP
    nello stesso package (per esempio LTST-C171KGKT, luminosità da verificare sul datasheet) e
    scegliere la resistenza con una prova sul prototipo; esclusi i verdi InGaN, con tensione
    diretta intorno ai 3 V e poco margine a 3,3 V;
  - saldature dei QFN: su Rev A sono state ripassate U3, U4, U5, J401 e U401; rivedere piazzole
    e aperture dello stencil, in particolare i pin d'angolo dell'UCS2114 (1 e 15).
- Completare i codici fornitore mancanti: U4/U5 (UCS2114-1-V/LX), U3 su Mouser e LCSC,
  R60/R61 (27 kΩ 1 %) su LCSC; campi `warehouse` vuoti per i componenti non a magazzino.
