mpolci/devhub/docs/requisiti.md

# Requisiti

## Problema da risolvere

Durante il test di schede a microcontrollore collegate via USB può servire scollegare e
ricollegare il cavo per recuperare un dispositivo bloccato. Devhub esegue questa operazione
dal PC, in modo scriptabile, e permette di gestire le porte e un relè ausiliario.
Non è uno strumento di misura: corrente e carica per porta sono indicative (D103), le tensioni
non si misurano.

Questi requisiti includono le semplificazioni D60–D66 e le decisioni D68–D87 in
[domande-aperte.md](domande-aperte.md). D75 seleziona UCS2114-1-V/LX e PI3USB4002A per le
porte, con due bus I²C indipendenti e scarica automatica configurata all’avvio; D78 conferma
USB2517I-JZX e STM32G0B1CEU6. Restano MCU separato, controllo HID e cicli autonomi; la
variante senza MCU non è adottata. Lo schema v0.3 applica questi requisiti (D79); il PCB
(D84) è realizzato e il prototipo è montato. D96–D101 precisano il comportamento del firmware.

## Requisiti funzionali

### Porte downstream

- **RF-1** 4 porte USB-C, tutte USB 2.0 Hi-Speed; nessuna porta USB-A (D66).
- **RF-2** Ogni porta può essere staccata e riattaccata su comando del PC: a porta
  disabilitata VBUS e D+/D− sono interrotte, GND resta collegata. Il distacco dei dati deve
  funzionare anche con dispositivi autoalimentati. Il ciclo di alimentazione riguarda le
  schede alimentate esclusivamente dalla porta USB; per spegnere una scheda alimentata anche
  esternamente occorre intervenire sulla sorgente esterna o sul reset, per esempio con un relè.
  Non si verifica elettricamente che la scheda si sia spenta né che abbia completato il riavvio.
- **RF-3** Alimentazione VBUS e dati D+/D− sono abilitati e disabilitati con un unico comando
  logico. È ammessa la sequenza interna del controller scelto, senza imporre ordine o ritardo
  regolabile fra alimentazione e dati. A porta disabilitata entrambe le connessioni devono
  risultare interrotte. Non sono richiesti comandi separati per dati e alimentazione.
- **RF-4** Il MCU esegue autonomamente un ciclo di spegnimento e riaccensione a seguito di
  un solo comando. È richiesta una **scarica attiva di VBUS**, anche integrata nel controller
  e automatica alla disabilitazione della porta. Non sono richiesti un GPIO DIS né un comando
  separato del MCU: scegliere il circuito complessivamente più semplice (D70).
  Il tempo di spegnimento è predefinito e configurabile: valore iniziale indicativo **1 s**,
  da confermare con il circuito scelto e sul prototipo. Si conta dal comando di disabilitazione
  di VBUS e comprende la scarica, senza attesa di una soglia misurata. Durata della scarica e
  intervallo configurabile devono rispettare i limiti del circuito, anche a porta lasciata
  spenta o in presenza di alimentazione esterna. Una scheda autoalimentata deve poter
  restare collegata indefinitamente senza danneggiare devhub, anche se sostiene VBUS:
  la scarica può interrompersi automaticamente (D71). La sorgente esterna ammessa è
  da 5 V nominali con tolleranza (D72); il massimo operativo numerico va fissato nel
  dimensionamento. Non è richiesta tolleranza della VBUS downstream a 12 o 20 V. Capacità molto elevate possono richiedere
  attese maggiori; una sorgente esterna non viene eliminata aumentando l'attesa.
- **RF-5** Ogni porta fornisce 5 V con almeno 2 A erogabili sulla singola porta USB-C,
  con **limitazione hardware della corrente**
  e segnalazione di guasto per porta. I valori per porta non sono disponibili simultaneamente
  su tutte le uscite: il totale è limitato dall'alimentatore e dai consumi interni (RF-13).
  Sulle USB-C resta l'annuncio di corrente standard USB tramite Rp da 56 kΩ (D30); non si
  annunciano 2 A sulle CC. Il limite hardware della porta resta distinto dall'annuncio USB.
- **RF-6** Corrente e carica erogata di ogni porta, lette dai controller delle porte senza
  componenti aggiunti, con la loro precisione e senza calibrazione; azzeramento della carica a
  comando o a ogni accensione della porta (D103). Non sono richieste misure di corrente
  all'ingresso, di tensione delle porte o della 5V_SYS, né diagnostica ricavata dalle misure.

### Dispositivo di controllo

- **RF-7** L'hub espone un dispositivo di controllo USB HID con usage page vendor, senza
  driver dedicati, utilizzabile su Linux, macOS e Windows.
- **RF-8** Il dispositivo di controllo resta raggiungibile con tutte le porte downstream
  disabilitate, tramite una porta interna non sezionabile, finché hub e MCU sono alimentati.
- **RF-9** Comandi: stato globale, stato logico e guasti hardware delle porte, on/off,
  ciclo con durata, comando e stato dei relè, impostazione dello stato di default all'accensione.
  Di fabbrica tutte le porte vengono abilitate dopo l’avvio, con accensioni sfalsate;
  è possibile salvare una configurazione diversa per porta (D74).
  Lo stato riportato non è una verifica elettrica della VBUS o del riavvio del dispositivo.
- **RF-10** Libreria Python generica e multipiattaforma, con CLI per macOS costruita sopra
  (es. `devhub port 2 cycle --ms 1000`).

### Relè ausiliario

- **RF-11** Un relè ausiliario SPDT, con due boccole a banana da 4 mm su COM/NC, comandabile
  dal PC (on/off e impulso di N ms) e da un pulsante sul pannello (RF-17).
- **RF-12** I contatti del relè sono galvanicamente isolati dall'hub; max 16 V / 3 A.

### Alimentazione

- **RF-13** Ingresso USB-C dedicato: è richiesto un alimentatore che offra **5 V / 3 A senza
  negoziazione USB-PD**, con cavo adeguato. Un alimentatore PD è compatibile solo se offre
  anche questa modalità; non tutti gli alimentatori PD la offrono. Alimentatore e cavo idonei
  sono a carico dell'utilizzatore; il funzionamento con capacità inferiore non è garantito.
  I 3 A sono totali all'ingresso e comprendono hub, MCU e relè; alle porte restano indicativamente
  ~2,4 A stimati mantenendo la logica attuale e un solo relè, da rivalutare con i componenti definitivi.
- **RF-14 — Eliminato (D65).** Nessuna lettura delle CC d'ingresso, verifica dell'annuncio
  di 3 A o gestione di budget diversi. Restano le resistenze Rd da 5,1 kΩ su CC1 e CC2,
  necessarie per ricevere alimentazione USB-C, e le protezioni hardware d'ingresso.
- **RF-15** Le accensioni multiple sono sfalsate per contenere l'inrush. Il firmware gestisce
  le segnalazioni di guasto disponibili dall'hardware. Il limite di ogni porta si può abbassare
  (D104); quando la corrente totale resta sopra quella dell'alimentatore il firmware riduce, e se
  serve spegne, la porta che consuma di più (D105). Un sovraccarico improvviso oltre il limite
  dell'eFuse può comunque interrompere l'intero hub. Non è garantita la continuità delle altre porte.
  Dopo un guasto hardware segnalato della porta, il MCU interrompe l’eventuale ciclo,
  disabilita VBUS e dati e mantiene il LED lampeggiante (D73). Il ripristino richiede
  un tentativo esplicito da pulsante o PC; se il guasto persiste, la porta torna bloccata.
  I guasti bloccanti sono sovracorrente e sovratemperatura; scarica non riuscita e tensione
  di ritorno, tipiche di una scheda autoalimentata, sono avvisi leggibili dal PC (D98).
- **RF-16 — Eliminato (D32).** Hub e MCU sono alimentati solo dall'alimentatore esterno;
  senza alimentatore l'hub non è visibile dal PC.

### Comandi sul pannello

- **RF-17** Cinque pulsanti: uno per ciascuna delle quattro USB-C e uno per il relè (D68).
  Ogni pressione alterna lo
  stato della porta (dati e alimentazione con un unico comando logico) o della linea del relè.
  I cambi di stato sono notificati all'host. Non è prevista una verifica del budget di corrente.
  Durante un ciclo la pressione lo annulla e lascia la porta disabilitata (D99). I pulsanti
  funzionano anche senza PC collegato; lo scollegamento o la sospensione del PC non cambiano
  lo stato di porte e relè (D100).

## Requisiti non funzionali

- **RNF-1** PCB a 4 strati realizzabile con prototipazione standard; componenti montabili
  a mano con piastra riscaldante e aria calda (strategia C in `architettura.md`).
- **RNF-2** Componenti reperibili presso distributori comuni (LCSC/JLCPCB, Mouser, DigiKey).
- **RNF-3** Restano le protezioni ESD sulle linee dati esposte, la protezione d'ingresso,
  la limitazione di corrente e il blocco della corrente inversa. Le protezioni non devono
  dipendere dalle misure eliminate; condizioni e limiti vanno verificati sul circuito scelto.
- **RNF-4** Firmware e strumento host open source e documentati; protocollo stabile e versionato.
- **RNF-5** **Un solo LED per porta USB**, pilotato dal MCU: spento = disabilitata,
  acceso fisso = abilitata, acceso con un breve spegnimento ogni secondo = abilitata con limite
  ridotto dal controllo della corrente totale (D105), lampeggiante = guasto. Il guasto ha priorità sull'indicazione di
  abilitazione; il dettaglio disponibile dall'hardware si legge dal PC. Il LED indica lo stato
  logico, non la presenza misurata di VBUS. LED di sistema: host collegato e relè (acceso a linea staccata); nessun LED di accensione (D82, D90).

## Fuori ambito (v1)

- USB 3.x SuperSpeed e isolamento galvanico delle porte USB.
- USB-PD all'ingresso o verso i dispositivi; ricarica del laptop/host dall'hub.
- Misura della corrente totale, telemetria delle tensioni e gestione dinamica del budget di potenza.
- Certificazione elettrica dello spegnimento e diagnosi di sorgenti esterne tramite misure.
- Riavvio automatico su blocco rilevato dal PC: è responsabilità degli script dell'utente.
