mpolci/devhub/hardware/devhub/production/bom.csv

Designator | Footprint | Quantity | Value | LCSC Part #
C10, C101, C103, C104, C201, C203, C204, C24, C301, C303, C304, C401, C403, C404, C60, C63, C83 | 0603 | 17 | 100n 0603
C102, C202, C302, C402 | 0805 | 4 | 22u 10V 0805
C106, C206, C306, C406, C61, C62, C64, C65, C7 | 0603 | 9 | 1u 25V 0603
C11 | 0603 | 1 | 2.2n 0603
C12 | 0603 | 1 | 10n 0603
C13 | 0603 | 1 | 100n 50V 0603
C20 | 0805 | 1 | 4.7u 0805
C21, C31, C32, C33, C35 | 0603 | 5 | 1u 0603
C22, C23 | 0603 | 2 | 15p C0G 0603
C25, C26, C27, C28, C29, C30, C37, C38, C41, C42, C46 | 0402 | 11 | 100n 0402
C3, C4 | CP_Elec_6.3x7.7 | 2 | 220u 16V
C40 | 0603 | 1 | 4.7u 0603
C5, C6, C8, C9 | 0805 | 4 | 10u 0805
C81 | 0805 | 1 | 100n 50V 0805 DNP
D1 | D_SMA | 1 | SMAJ20A
D102, D202, D302, D402, D90 | 0805 | 5 | verde 0805
D2 | D_SMA | 1 | SS34
D20 | SOT-23-6 | 1 | USBLC6-2SC6
D4 | D_SOD-123 | 1 | BZT52C5V1
D93 | 0805 | 1 | arancio 0805
J1 | USB_C_Receptacle_GCT_USB4105-xx-A_16P_TopMnt_Horizontal | 1 | USB-C PWR IN
J101, J201, J301, J401 | USB_C_Receptacle_GCT_USB4105-xx-A_16P_TopMnt_Horizontal | 4 | USB-C
J2 | USB_C_Receptacle_GCT_USB4105-xx-A_16P_TopMnt_Horizontal | 1 | USB-C UPSTREAM
J4 | PinHeader_2x05_P1.27mm_Vertical_SMD | 1 | SWD
J5 | Banana_Cliff_FCR7350B_S16N-PC_Horizontal | 1 | Banana COM 1
J6 | Banana_Cliff_FCR7350R_S16N-PC_Horizontal | 1 | Banana NC 1
JP2 | SolderJumper-3_P2.4mm_Bridged12_Pad2.0x3.0mm | 1 | NC/NO
K1 | Relay_SPDT_Omron-G5Q-1 | 1 | G5Q-1 DC5
R1, R2, R20, R21 | 0603 | 4 | 5.1k 0603
R102, R103, R202, R203, R302, R303, R402, R403 | 0603 | 8 | 56k 0603
R104, R204, R22, R23, R304, R404 | 0603 | 6 | 100k 0603
R106, R206, R306, R406, R90, R93 | 0603 | 6 | 1k 0603
R24 | 0603 | 1 | 1M 0603
R25 | 0603 | 1 | 12.0k 1% 0603
R26, R27, R28, R29, R34, R42, R43, R44, R45, R48, R49, R62, R63, R64, R65 | 0603 | 15 | 10k 0603
R30 | 0603 | 1 | 68.1k 1% 0603
R31 | 0603 | 1 | 8.66k 1% 0603
R32 | 0603 | 1 | 20.5k 1% 0603
R33 | 0603 | 1 | 953 1% 0603
R40, R41, R50, R51 | 0603 | 4 | 4.7k 0603
R60, R61 | 0603 | 2 | 27k 1% 0603
R81 | 1206 | 1 | 100 0.25W 1206 DNP
SW1, SW101, SW201, SW301, SW401 | SW_SPST_PTS645Sx43SMTR92 | 5 | Push button switch, generic, two pins
TP1, TP10 | TestPoint_Keystone_5000-5004_Miniature | 2 | Keystone 5001
U1 | SOT-223-3_TabPin2 | 1 | AP7361C-33ER
U101, U201, U301, U401 | C3657361_UQFN-10_L2_0-W1_5-P0_50-TL | 4 | PI3USB4002A
U12 | SOT-23 | 1 | MCP120T-300I/TT
U13 | C3662799_VQFN-10_L2_0-W2_0-P0_45-TL | 1 | TPS259470ARPWR
U2 | QFN-64-1EP_9x9mm_P0.5mm_EP4.7x4.7mm_ThermalVias_0.3mm | 1 | USB2517I-JZX
U3 | QFN-48-1EP_7x7mm_P0.5mm_EP5.6x5.6mm | 1 | STM32G0B1CEU6
U4, U5 | UCS2114_VQFN-20_3x3mm_P0.5mm | 2 | UCS2114-1-V/LX
U9 | SOIC-16_3.9x9.9mm_P1.27mm | 1 | ULN2003V12
Y1 | Crystal_SMD_3225-4Pin_3.2x2.5mm | 1 | 24MHz 12pF
