mpolci/devhub/hardware/devhub/devhub.kicad_pcb

## KiCad design hardware/devhub/devhub.kicad_pcb (2026-11-10)

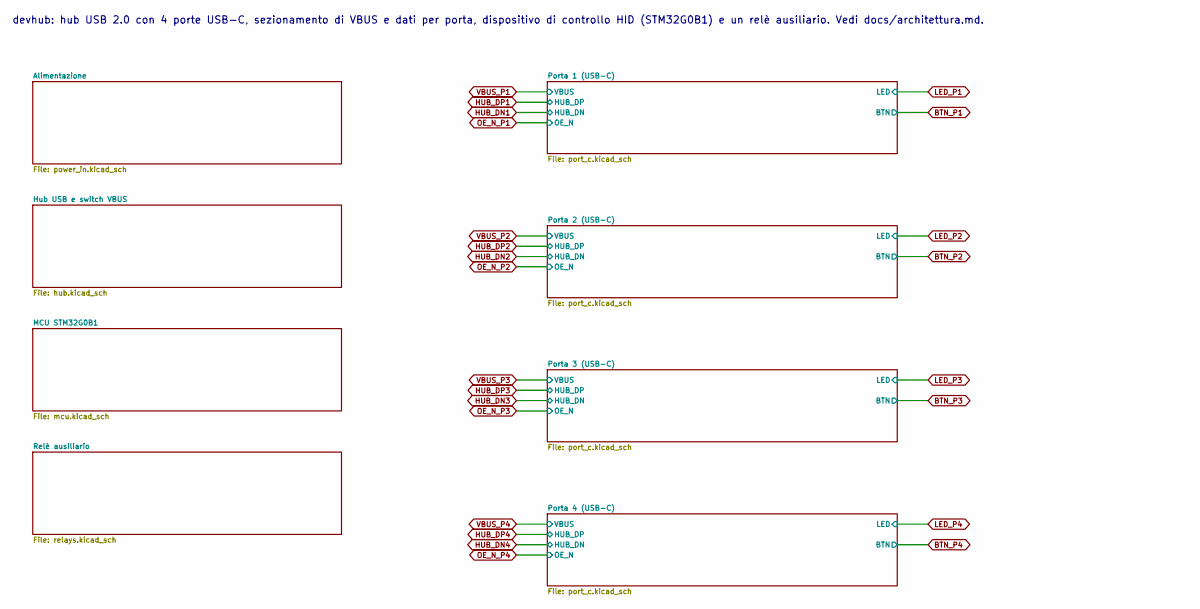
[picture p1: schematic devhub.kicad_sch, devhub - hub USB per lo sviluppo hardware]

Notes on the sheet:
devhub: hub USB 2.0 con 4 porte USB-C, sezionamento di VBUS e dati per porta, dispositivo di controllo HID (STM32G0B1) e un relè ausiliario. Vedi docs/architettura.md.

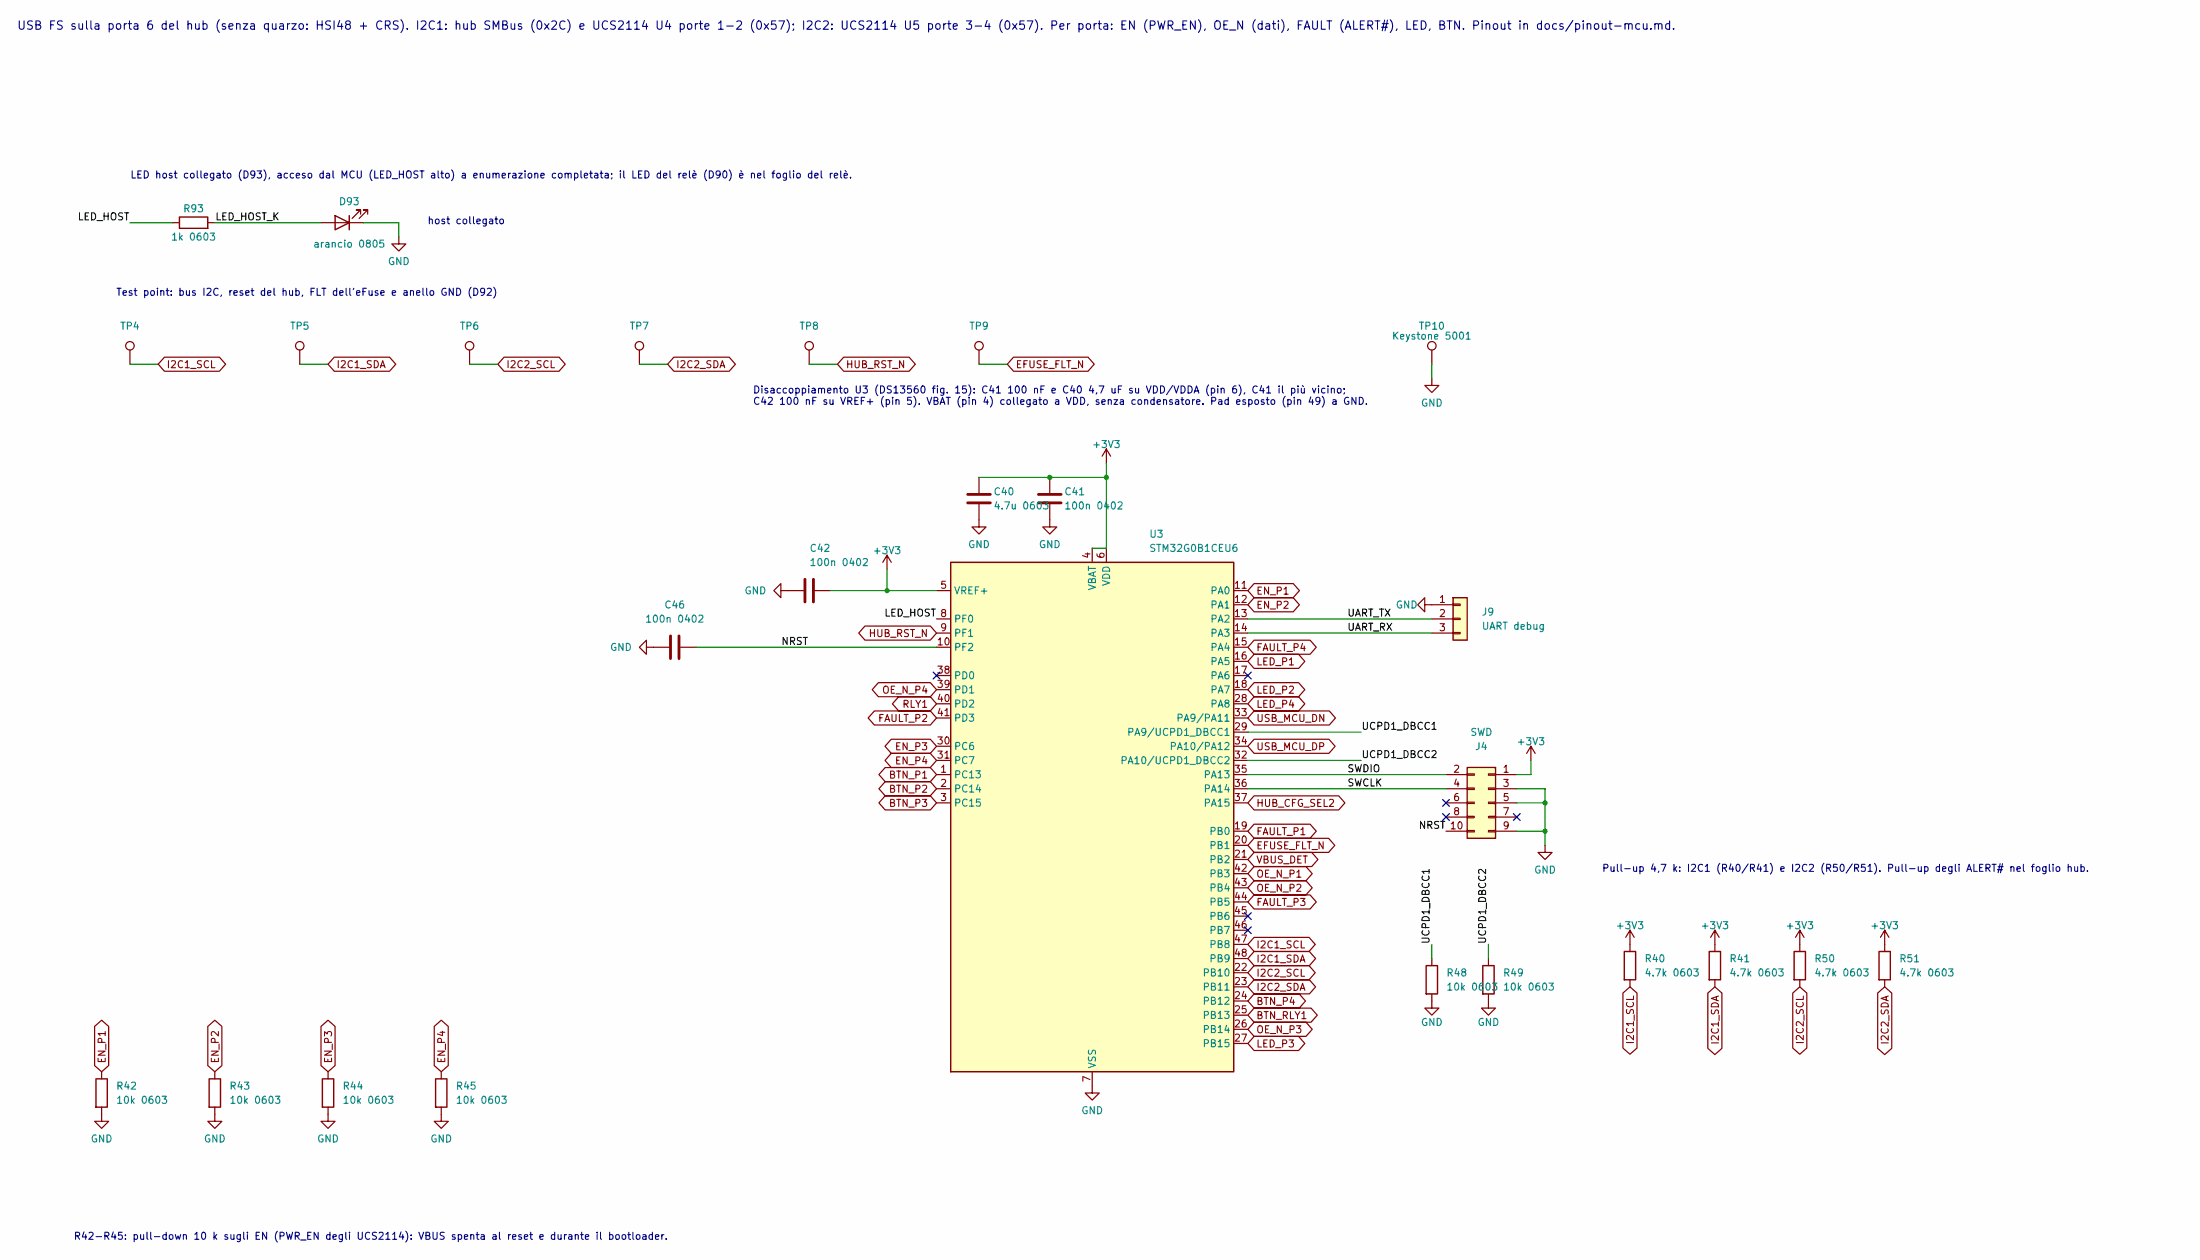
[picture p2: schematic mcu.kicad_sch, MCU di controllo STM32G0B1CEU6 e LED host]

Parts:
C40: 4.7u 0603; C_0603_1608Metric; MPN lcsc CL10A475KO8NNNC; lcsc C19666
C41, C42, C46: 100n 0402; C_0402_1005Metric; MPN lcsc CC0402KRX7R7BB104; lcsc C60474
D93: arancio 0805; LED_0805_2012Metric; MPN lcsc LTST-C171KFKT; lcsc C284932
J4: SWD; PinHeader_2x05_P1.27mm_Vertical_SMD; MPN lcsc FTSH-105-01-L-DV-K; lcsc C5155080
J9: UART debug; PinHeader_1x03_P2.54mm_Vertical; MPN lcsc 2.54-1*3P; lcsc C49257
R40, R41, R50, R51: 4.7k 0603; R_0603_1608Metric; MPN lcsc RC0603FR-074K7L; lcsc C99782
R42, R43, R44, R45, R48, R49: 10k 0603; R_0603_1608Metric; MPN lcsc FRC0603F1002TS; lcsc C2906982
R93: 1k 0603; R_0603_1608Metric; MPN lcsc 0603WAF1001T5E; lcsc C21190
TP4: I2C1_SCL; TestPoint_Pad_D1.5mm
TP5: I2C1_SDA; TestPoint_Pad_D1.5mm
TP6: I2C2_SCL; TestPoint_Pad_D1.5mm
TP7: I2C2_SDA; TestPoint_Pad_D1.5mm
TP8: HUB_RST_N; TestPoint_Pad_D1.5mm
TP9: EFUSE_FLT_N; TestPoint_Pad_D1.5mm
TP10: Keystone 5001; TestPoint_Keystone_5000-5004_Miniature; MPN mouser 5001; lcsc C238122
U3: STM32G0B1CEU6; QFN-48-1EP_7x7mm_P0.5mm_EP5.6x5.6mm; MPN lcsc STM32G0B1CEU6; lcsc C2829190

Connections:
+3V3: C40.1, C41.1, C42.1, J4.1, R40.1, R41.1, R50.1, R51.1, U3.4 (VBAT), U3.5 (VREF+), U3.6 (VDD); also elsewhere on the board
/MCU STM32G0B1/LED_HOST: R93.1, U3.8 (PF0)
/MCU STM32G0B1/LED_HOST_K: D93.2 (A), R93.2
/MCU STM32G0B1/NRST: C46.1, J4.10, U3.10 (PF2)
/MCU STM32G0B1/SWCLK: J4.4, U3.36 (PA14)
/MCU STM32G0B1/SWDIO: J4.2, U3.35 (PA13)
/MCU STM32G0B1/UART_RX: J9.3, U3.14 (PA3)
/MCU STM32G0B1/UART_TX: J9.2, U3.13 (PA2)
/MCU STM32G0B1/UCPD1_DBCC1: R48.1, U3.29 (PA9/UCPD1_DBCC1)
/MCU STM32G0B1/UCPD1_DBCC2: R49.1, U3.32 (PA10/UCPD1_DBCC2)
BTN_P1: U3.1 (PC13); also elsewhere on the board
BTN_P2: U3.2 (PC14); also elsewhere on the board
BTN_P3: U3.3 (PC15); also elsewhere on the board
BTN_P4: U3.24 (PB12); also elsewhere on the board
BTN_RLY1: U3.25 (PB13); also elsewhere on the board
EFUSE_FLT_N: TP9.1 (1_1), U3.20 (PB1); also elsewhere on the board
EN_P1: R42.1, U3.11 (PA0); also elsewhere on the board
EN_P2: R43.1, U3.12 (PA1); also elsewhere on the board
EN_P3: R44.1, U3.30 (PC6); also elsewhere on the board
EN_P4: R45.1, U3.31 (PC7); also elsewhere on the board
FAULT_P1: U3.19 (PB0); also elsewhere on the board
FAULT_P2: U3.41 (PD3); also elsewhere on the board
FAULT_P3: U3.44 (PB5); also elsewhere on the board
FAULT_P4: U3.15 (PA4); also elsewhere on the board
GND: C40.2, C41.2, C42.2, C46.2, D93.1 (K), J4.3, J4.5, J4.9, J9.1, R42.2, R43.2, R44.2, R45.2, R48.2, R49.2, TP10.1 (1_1), U3.7 (VSS), U3.49 (VSS); also elsewhere on the board
HUB_CFG_SEL2: U3.37 (PA15); also elsewhere on the board
HUB_RST_N: TP8.1 (1_1), U3.9 (PF1); also elsewhere on the board
I2C1_SCL: R40.2, TP4.1 (1_1), U3.47 (PB8); also elsewhere on the board
I2C1_SDA: R41.2, TP5.1 (1_1), U3.48 (PB9); also elsewhere on the board
I2C2_SCL: R50.2, TP6.1 (1_1), U3.22 (PB10); also elsewhere on the board
I2C2_SDA: R51.2, TP7.1 (1_1), U3.23 (PB11); also elsewhere on the board
LED_P1: U3.16 (PA5); also elsewhere on the board
LED_P2: U3.18 (PA7); also elsewhere on the board
LED_P3: U3.27 (PB15); also elsewhere on the board
LED_P4: U3.28 (PA8); also elsewhere on the board
OE_N_P1: U3.42 (PB3); also elsewhere on the board
OE_N_P2: U3.43 (PB4); also elsewhere on the board
OE_N_P3: U3.26 (PB14); also elsewhere on the board
OE_N_P4: U3.39 (PD1); also elsewhere on the board
RLY1: U3.40 (PD2); also elsewhere on the board
USB_MCU_DN: U3.33 (PA9/PA11); also elsewhere on the board
USB_MCU_DP: U3.34 (PA10/PA12); also elsewhere on the board
VBUS_DET: U3.21 (PB2); also elsewhere on the board

Notes on the sheet:
Disaccoppiamento U3 (DS13560 fig. 15): C41 100 nF e C40 4,7 uF su VDD/VDDA (pin 6), C41 il più vicino; C42 100 nF su VREF+ (pin 5). VBAT (pin 4) collegato a VDD, senza condensatore. Pad esposto (pin 49) a GND.
Test point: bus I2C, reset del hub, FLT dell'eFuse e anello GND (D92)
USB FS sulla porta 6 del hub (senza quarzo: HSI48 + CRS). I2C1: hub SMBus (0x2C) e UCS2114 U4 porte 1-2 (0x57); I2C2: UCS2114 U5 porte 3-4 (0x57). Per porta: EN (PWR_EN), OE_N (dati), FAULT (ALERT#), LED, BTN. Pinout in docs/pinout-mcu.md.
Pull-up 4,7 k: I2C1 (R40/R41) e I2C2 (R50/R51). Pull-up degli ALERT# nel foglio hub.
host collegato
LED host collegato (D93), acceso dal MCU (LED_HOST alto) a enumerazione completata; il LED del relè (D90) è nel foglio del relè.
R42-R45: pull-down 10 k sugli EN (PWR_EN degli UCS2114): VBUS spenta al reset e durante il bootloader.

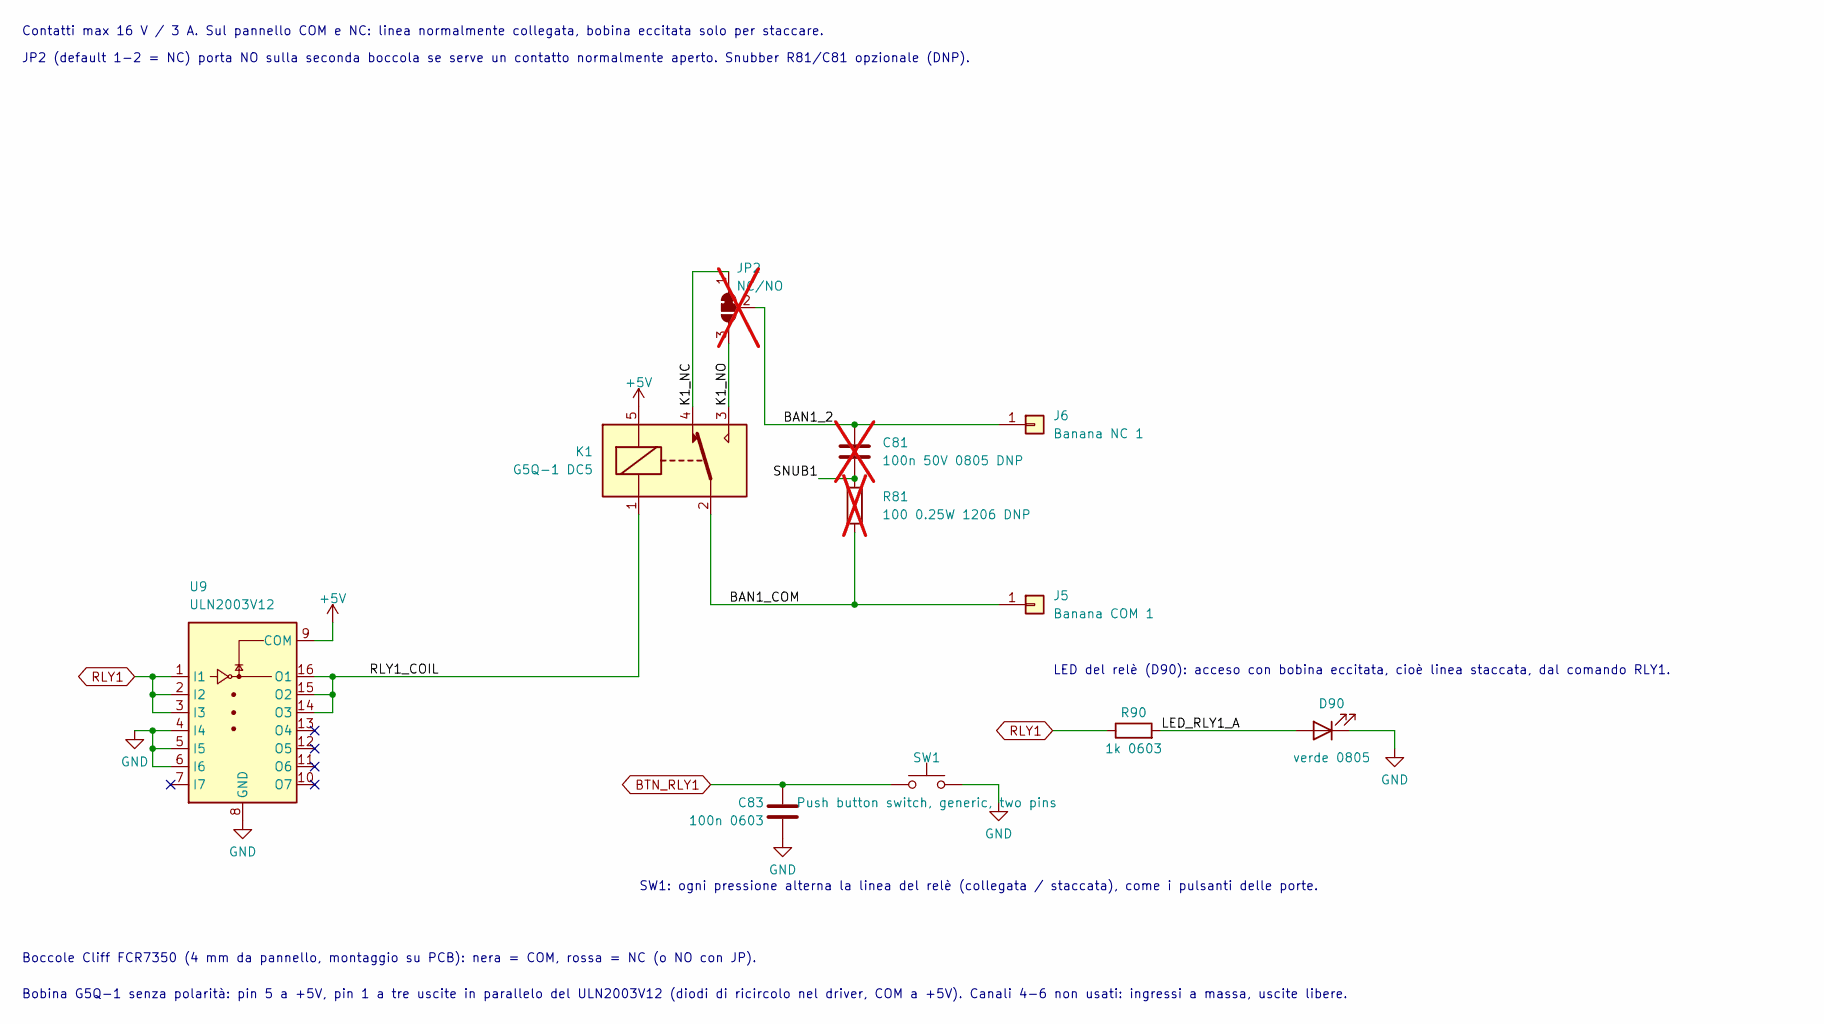
[picture p3: schematic relays.kicad_sch, Relè ausiliario su boccole a banana]

Parts:
C81: 100n 50V 0805 DNP; C_0805_2012Metric; MPN lcsc 0805B104K500CT; lcsc C83055; not fitted
C83: 100n 0603; C_0603_1608Metric; MPN lcsc CL10B104KB8NNNC; lcsc C1591
D90: verde 0805; LED_0805_2012Metric; MPN lcsc LTST-C171GKT; lcsc C913075
J5: Banana COM 1; Banana_Cliff_FCR7350B_S16N-PC_Horizontal; MPN digikey FCR7350B; digikey 4654-FCR7350B-ND
J6: Banana NC 1; Banana_Cliff_FCR7350R_S16N-PC_Horizontal; MPN lcsc FCR7350R; lcsc C6041087
JP2: NC/NO; SolderJumper-3_P2.4mm_Bridged12_Pad2.0x3.0mm; not fitted
K1: G5Q-1 DC5; Relay_SPDT_Omron-G5Q-1; MPN lcsc G5Q-14 DC5; lcsc C397241
R81: 100 0.25W 1206 DNP; R_1206_3216Metric; MPN lcsc RC1206FR-07100RL; lcsc C137392; not fitted
R90: 1k 0603; R_0603_1608Metric; MPN lcsc 0603WAF1001T5E; lcsc C21190
SW1: Push button switch, generic, two pins; SW_SPST_PTS645Sx43SMTR92; MPN lcsc PTS645SL70SMTR92 LFS; lcsc C285485
U9: ULN2003V12; SOIC-16_3.9x9.9mm_P1.27mm; MPN lcsc ULN2003V12DR; lcsc C94916

Connections:
+5V: K1.5, U9.9 (COM); also elsewhere on the board
/Relè ausiliario/BAN1_2: C81.1, J6.1 (Pin_1_1), JP2.2 (C)
/Relè ausiliario/BAN1_COM: J5.1 (Pin_1_1), K1.2, R81.2
/Relè ausiliario/K1_NC: JP2.1 (A), K1.4
/Relè ausiliario/K1_NO: JP2.3 (B), K1.3
/Relè ausiliario/LED_RLY1_A: D90.2 (A), R90.2
/Relè ausiliario/RLY1_COIL: K1.1, U9.14 (O3), U9.15 (O2), U9.16 (O1)
/Relè ausiliario/SNUB1: C81.2, R81.1
BTN_RLY1: C83.1, SW1.1; also elsewhere on the board
GND: C83.2, D90.1 (K), SW1.2, U9.4 (I4), U9.5 (I5), U9.6 (I6), U9.8 (GND); also elsewhere on the board
RLY1: R90.1, U9.1 (I1), U9.2 (I2), U9.3 (I3); also elsewhere on the board

Notes on the sheet:
Bobina G5Q-1 senza polarità: pin 5 a +5V, pin 1 a tre uscite in parallelo del ULN2003V12 (diodi di ricircolo nel driver, COM a +5V). Canali 4-6 non usati: ingressi a massa, uscite libere.
JP2 (default 1-2 = NC) porta NO sulla seconda boccola se serve un contatto normalmente aperto. Snubber R81/C81 opzionale (DNP).
Boccole Cliff FCR7350 (4 mm da pannello, montaggio su PCB): nera = COM, rossa = NC (o NO con JP).
Contatti max 16 V / 3 A. Sul pannello COM e NC: linea normalmente collegata, bobina eccitata solo per staccare.
LED del relè (D90): acceso con bobina eccitata, cioè linea staccata, dal comando RLY1.
SW1: ogni pressione alterna la linea del relè (collegata / staccata), come i pulsanti delle porte.

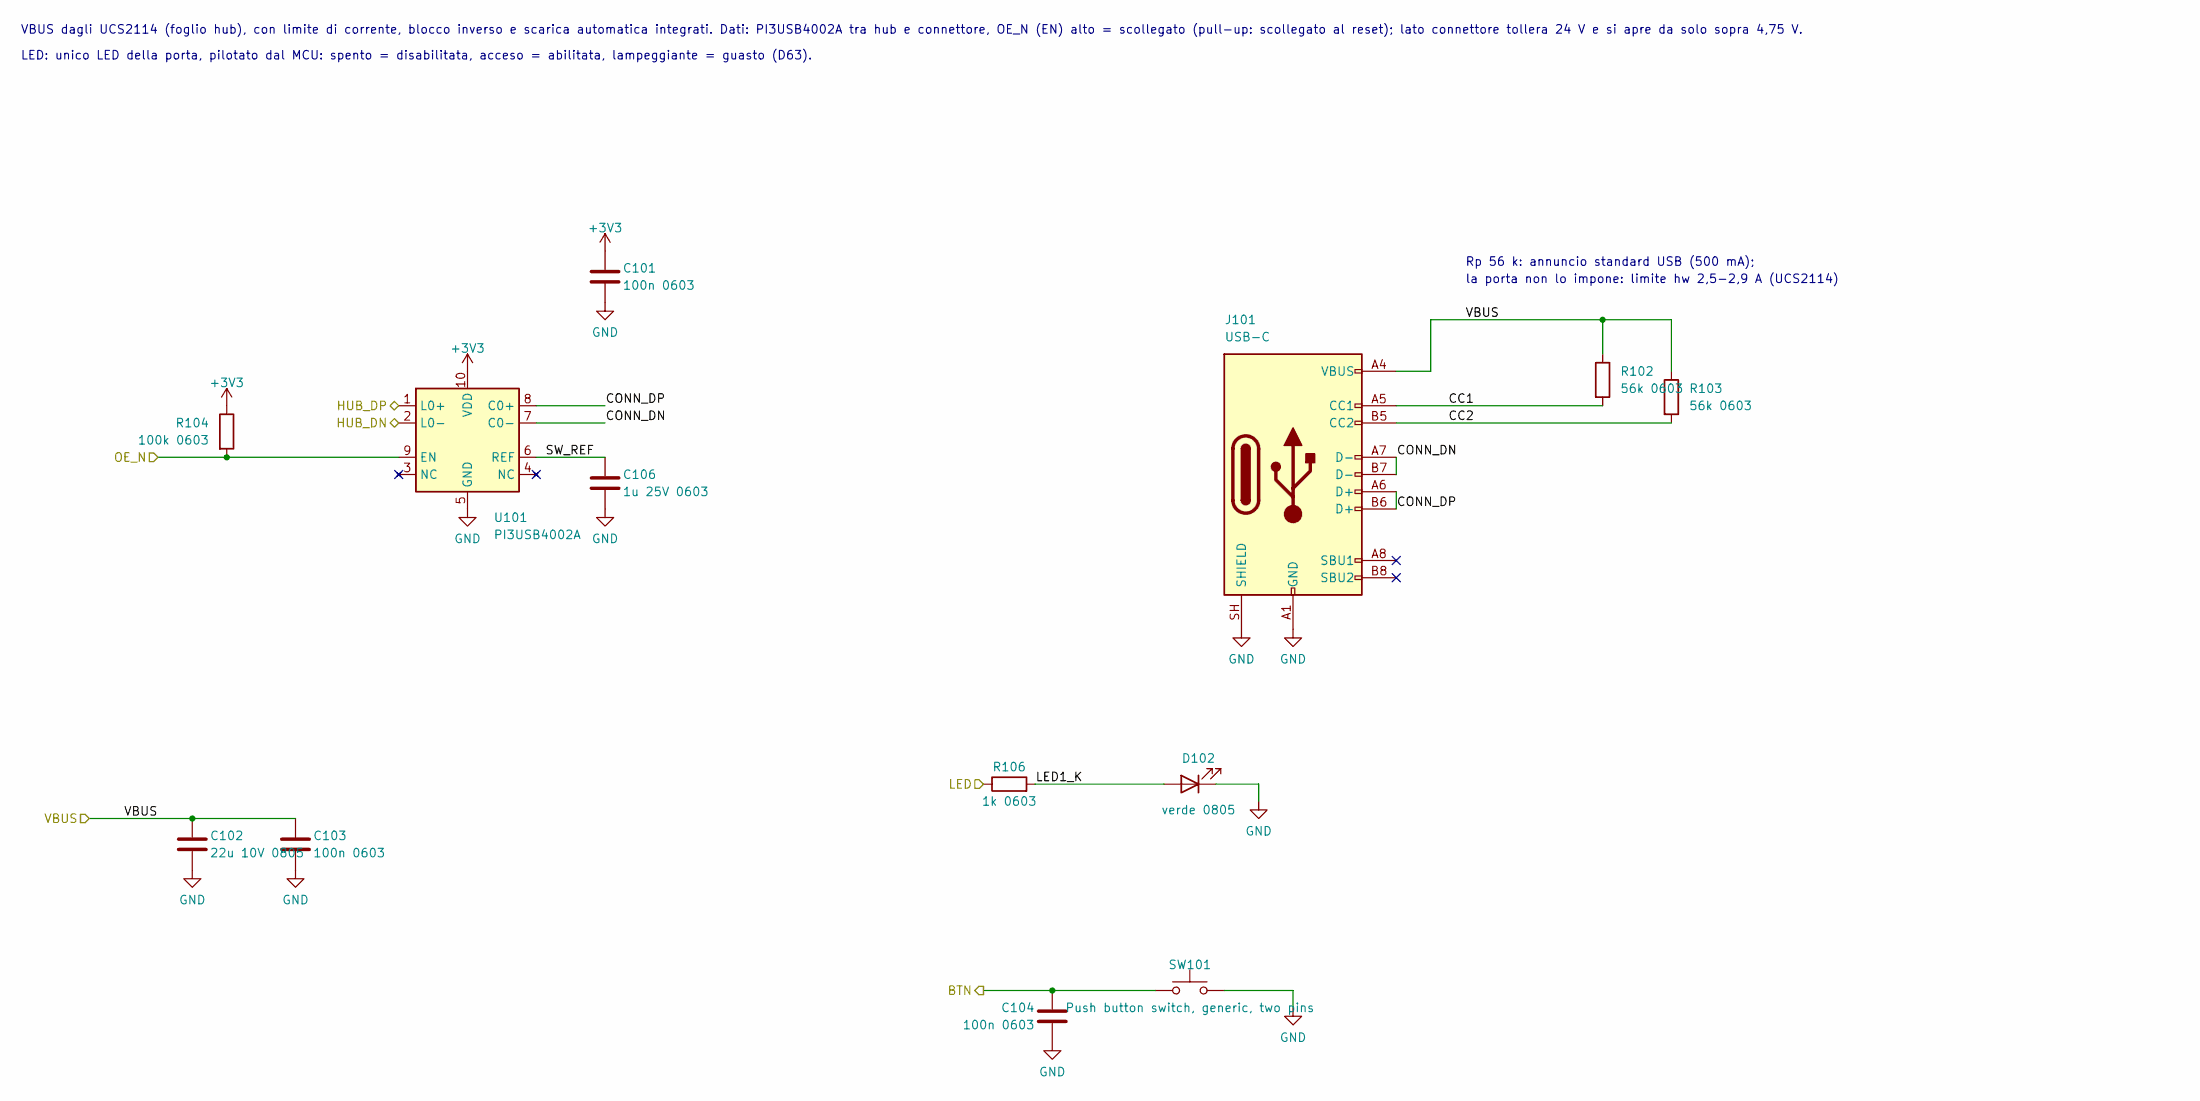
[picture p4: schematic port_c.kicad_sch, Porta downstream USB-C]

Parts:
C101, C103, C104: 100n 0603; C_0603_1608Metric; MPN lcsc CL10B104KB8NNNC; lcsc C1591
C102: 22u 10V 0805; C_0805_2012Metric; MPN lcsc GRM21BZ71A226ME15L; lcsc C907991
C106: 1u 25V 0603; C_0603_1608Metric; MPN lcsc CL10B105KA8NNNC; lcsc C29936
D102: verde 0805; LED_0805_2012Metric; MPN lcsc LTST-C171GKT; lcsc C913075
J101: USB-C; USB_C_Receptacle_GCT_USB4105-xx-A_16P_TopMnt_Horizontal; MPN lcsc USB4105-GF-A; lcsc C3020560
R102, R103: 56k 0603; R_0603_1608Metric; MPN lcsc RC0603FR-0756KL; lcsc C114630
R104: 100k 0603; R_0603_1608Metric; MPN lcsc FRC0603F1003TS; lcsc C2906980
R106: 1k 0603; R_0603_1608Metric; MPN lcsc 0603WAF1001T5E; lcsc C21190
SW101: Push button switch, generic, two pins; SW_SPST_PTS645Sx43SMTR92; MPN lcsc PTS645SL70SMTR92 LFS; lcsc C285485
U101: PI3USB4002A; C3657361_UQFN-10_L2_0-W1_5-P0_50-TL; MPN lcsc PI3USB4002AZUAEX; lcsc C6735706

Connections:
+3V3: C101.1, R104.1, U101.10 (VDD); also elsewhere on the board
/Porta 1 (USB-C)/CC1: J101.A5 (CC1), R102.2
/Porta 1 (USB-C)/CC2: J101.B5 (CC2), R103.2
/Porta 1 (USB-C)/CONN_DN: J101.A7 (D-), J101.B7 (D-), U101.7 (C0-)
/Porta 1 (USB-C)/CONN_DP: J101.A6 (D+), J101.B6 (D+), U101.8 (C0+)
/Porta 1 (USB-C)/LED1_K: D102.2 (A), R106.2
/Porta 1 (USB-C)/SW_REF: C106.1, U101.6 (REF)
BTN_P1: C104.1, SW101.1; also elsewhere on the board
GND: C101.2, C102.2, C103.2, C104.2, C106.2, D102.1 (K), J101.A1 (GND), J101.A12 (GND), J101.B1 (GND), J101.B12 (GND), J101.SH (SHIELD), SW101.2, U101.5 (GND); also elsewhere on the board
HUB_DN1: U101.2 (L0-); also elsewhere on the board
HUB_DP1: U101.1 (L0+); also elsewhere on the board
LED_P1: R106.1; also elsewhere on the board
OE_N_P1: R104.2, U101.9 (EN); also elsewhere on the board
VBUS_P1: C102.1, C103.1, J101.A4 (VBUS), J101.A9 (VBUS), J101.B4 (VBUS), J101.B9 (VBUS), R102.1, R103.1; also elsewhere on the board

Parts of its further copies:
C201, C203, C204, C301, C303, C304, C401, C403, C404: 100n 0603; C_0603_1608Metric; MPN lcsc CL10B104KB8NNNC; lcsc C1591
C202, C302, C402: 22u 10V 0805; C_0805_2012Metric; MPN lcsc GRM21BZ71A226ME15L; lcsc C907991
C206, C306, C406: 1u 25V 0603; C_0603_1608Metric; MPN lcsc CL10B105KA8NNNC; lcsc C29936
D202, D302, D402: verde 0805; LED_0805_2012Metric; MPN lcsc LTST-C171GKT; lcsc C913075
J201, J301, J401: USB-C; USB_C_Receptacle_GCT_USB4105-xx-A_16P_TopMnt_Horizontal; MPN lcsc USB4105-GF-A; lcsc C3020560
R202, R203, R302, R303, R402, R403: 56k 0603; R_0603_1608Metric; MPN lcsc RC0603FR-0756KL; lcsc C114630
R204, R304, R404: 100k 0603; R_0603_1608Metric; MPN lcsc FRC0603F1003TS; lcsc C2906980
R206, R306, R406: 1k 0603; R_0603_1608Metric; MPN lcsc 0603WAF1001T5E; lcsc C21190
SW201, SW301, SW401: Push button switch, generic, two pins; SW_SPST_PTS645Sx43SMTR92; MPN lcsc PTS645SL70SMTR92 LFS; lcsc C285485
U201, U301, U401: PI3USB4002A; C3657361_UQFN-10_L2_0-W1_5-P0_50-TL; MPN lcsc PI3USB4002AZUAEX; lcsc C6735706

Connections of its further copies:
+3V3: C201.1, C301.1, C401.1, R204.1, R304.1, R404.1, U201.10 (VDD), U301.10 (VDD), U401.10 (VDD); also elsewhere on the board
/Porta 2 (USB-C)/CC1: J201.A5 (CC1), R202.2
/Porta 2 (USB-C)/CC2: J201.B5 (CC2), R203.2
/Porta 2 (USB-C)/CONN_DN: J201.A7 (D-), J201.B7 (D-), U201.7 (C0-)
/Porta 2 (USB-C)/CONN_DP: J201.A6 (D+), J201.B6 (D+), U201.8 (C0+)
/Porta 2 (USB-C)/LED1_K: D202.2 (A), R206.2
/Porta 2 (USB-C)/SW_REF: C206.1, U201.6 (REF)
/Porta 3 (USB-C)/CC1: J301.A5 (CC1), R302.2
/Porta 3 (USB-C)/CC2: J301.B5 (CC2), R303.2
/Porta 3 (USB-C)/CONN_DN: J301.A7 (D-), J301.B7 (D-), U301.7 (C0-)
/Porta 3 (USB-C)/CONN_DP: J301.A6 (D+), J301.B6 (D+), U301.8 (C0+)
/Porta 3 (USB-C)/LED1_K: D302.2 (A), R306.2
/Porta 3 (USB-C)/SW_REF: C306.1, U301.6 (REF)
/Porta 4 (USB-C)/CC1: J401.A5 (CC1), R402.2
/Porta 4 (USB-C)/CC2: J401.B5 (CC2), R403.2
/Porta 4 (USB-C)/CONN_DN: J401.A7 (D-), J401.B7 (D-), U401.7 (C0-)
/Porta 4 (USB-C)/CONN_DP: J401.A6 (D+), J401.B6 (D+), U401.8 (C0+)
/Porta 4 (USB-C)/LED1_K: D402.2 (A), R406.2
/Porta 4 (USB-C)/SW_REF: C406.1, U401.6 (REF)
BTN_P2: C204.1, SW201.1; also elsewhere on the board
BTN_P3: C304.1, SW301.1; also elsewhere on the board
BTN_P4: C404.1, SW401.1; also elsewhere on the board
GND: C201.2, C202.2, C203.2, C204.2, C206.2, C301.2, C302.2, C303.2, C304.2, C306.2, C401.2, C402.2, C403.2, C404.2, C406.2, D202.1 (K), D302.1 (K), D402.1 (K), J201.A1 (GND), J201.A12 (GND), J201.B1 (GND), J201.B12 (GND), J201.SH (SHIELD), J301.A1 (GND), J301.A12 (GND), J301.B1 (GND), J301.B12 (GND), J301.SH (SHIELD), J401.A1 (GND), J401.A12 (GND), J401.B1 (GND), J401.B12 (GND), J401.SH (SHIELD), SW201.2, SW301.2, SW401.2, U201.5 (GND), U301.5 (GND), U401.5 (GND); also elsewhere on the board
HUB_DN2: U201.2 (L0-); also elsewhere on the board
HUB_DN3: U301.2 (L0-); also elsewhere on the board
HUB_DN4: U401.2 (L0-); also elsewhere on the board
HUB_DP2: U201.1 (L0+); also elsewhere on the board
HUB_DP3: U301.1 (L0+); also elsewhere on the board
HUB_DP4: U401.1 (L0+); also elsewhere on the board
LED_P2: R206.1; also elsewhere on the board
LED_P3: R306.1; also elsewhere on the board
LED_P4: R406.1; also elsewhere on the board
OE_N_P2: R204.2, U201.9 (EN); also elsewhere on the board
OE_N_P3: R304.2, U301.9 (EN); also elsewhere on the board
OE_N_P4: R404.2, U401.9 (EN); also elsewhere on the board
VBUS_P2: C202.1, C203.1, J201.A4 (VBUS), J201.A9 (VBUS), J201.B4 (VBUS), J201.B9 (VBUS), R202.1, R203.1; also elsewhere on the board
VBUS_P3: C302.1, C303.1, J301.A4 (VBUS), J301.A9 (VBUS), J301.B4 (VBUS), J301.B9 (VBUS), R302.1, R303.1; also elsewhere on the board
VBUS_P4: C402.1, C403.1, J401.A4 (VBUS), J401.A9 (VBUS), J401.B4 (VBUS), J401.B9 (VBUS), R402.1, R403.1; also elsewhere on the board

Notes on the sheet:
VBUS dagli UCS2114 (foglio hub), con limite di corrente, blocco inverso e scarica automatica integrati. Dati: PI3USB4002A tra hub e connettore, OE_N (EN) alto = scollegato (pull-up: scollegato al reset); lato connettore tollera 24 V e si apre da solo sopra 4,75 V.
LED: unico LED della porta, pilotato dal MCU: spento = disabilitata, acceso = abilitata, lampeggiante = guasto (D63).
la porta non lo impone: limite hw 2,5-2,9 A (UCS2114)
Rp 56 k: annuncio standard USB (500 mA);

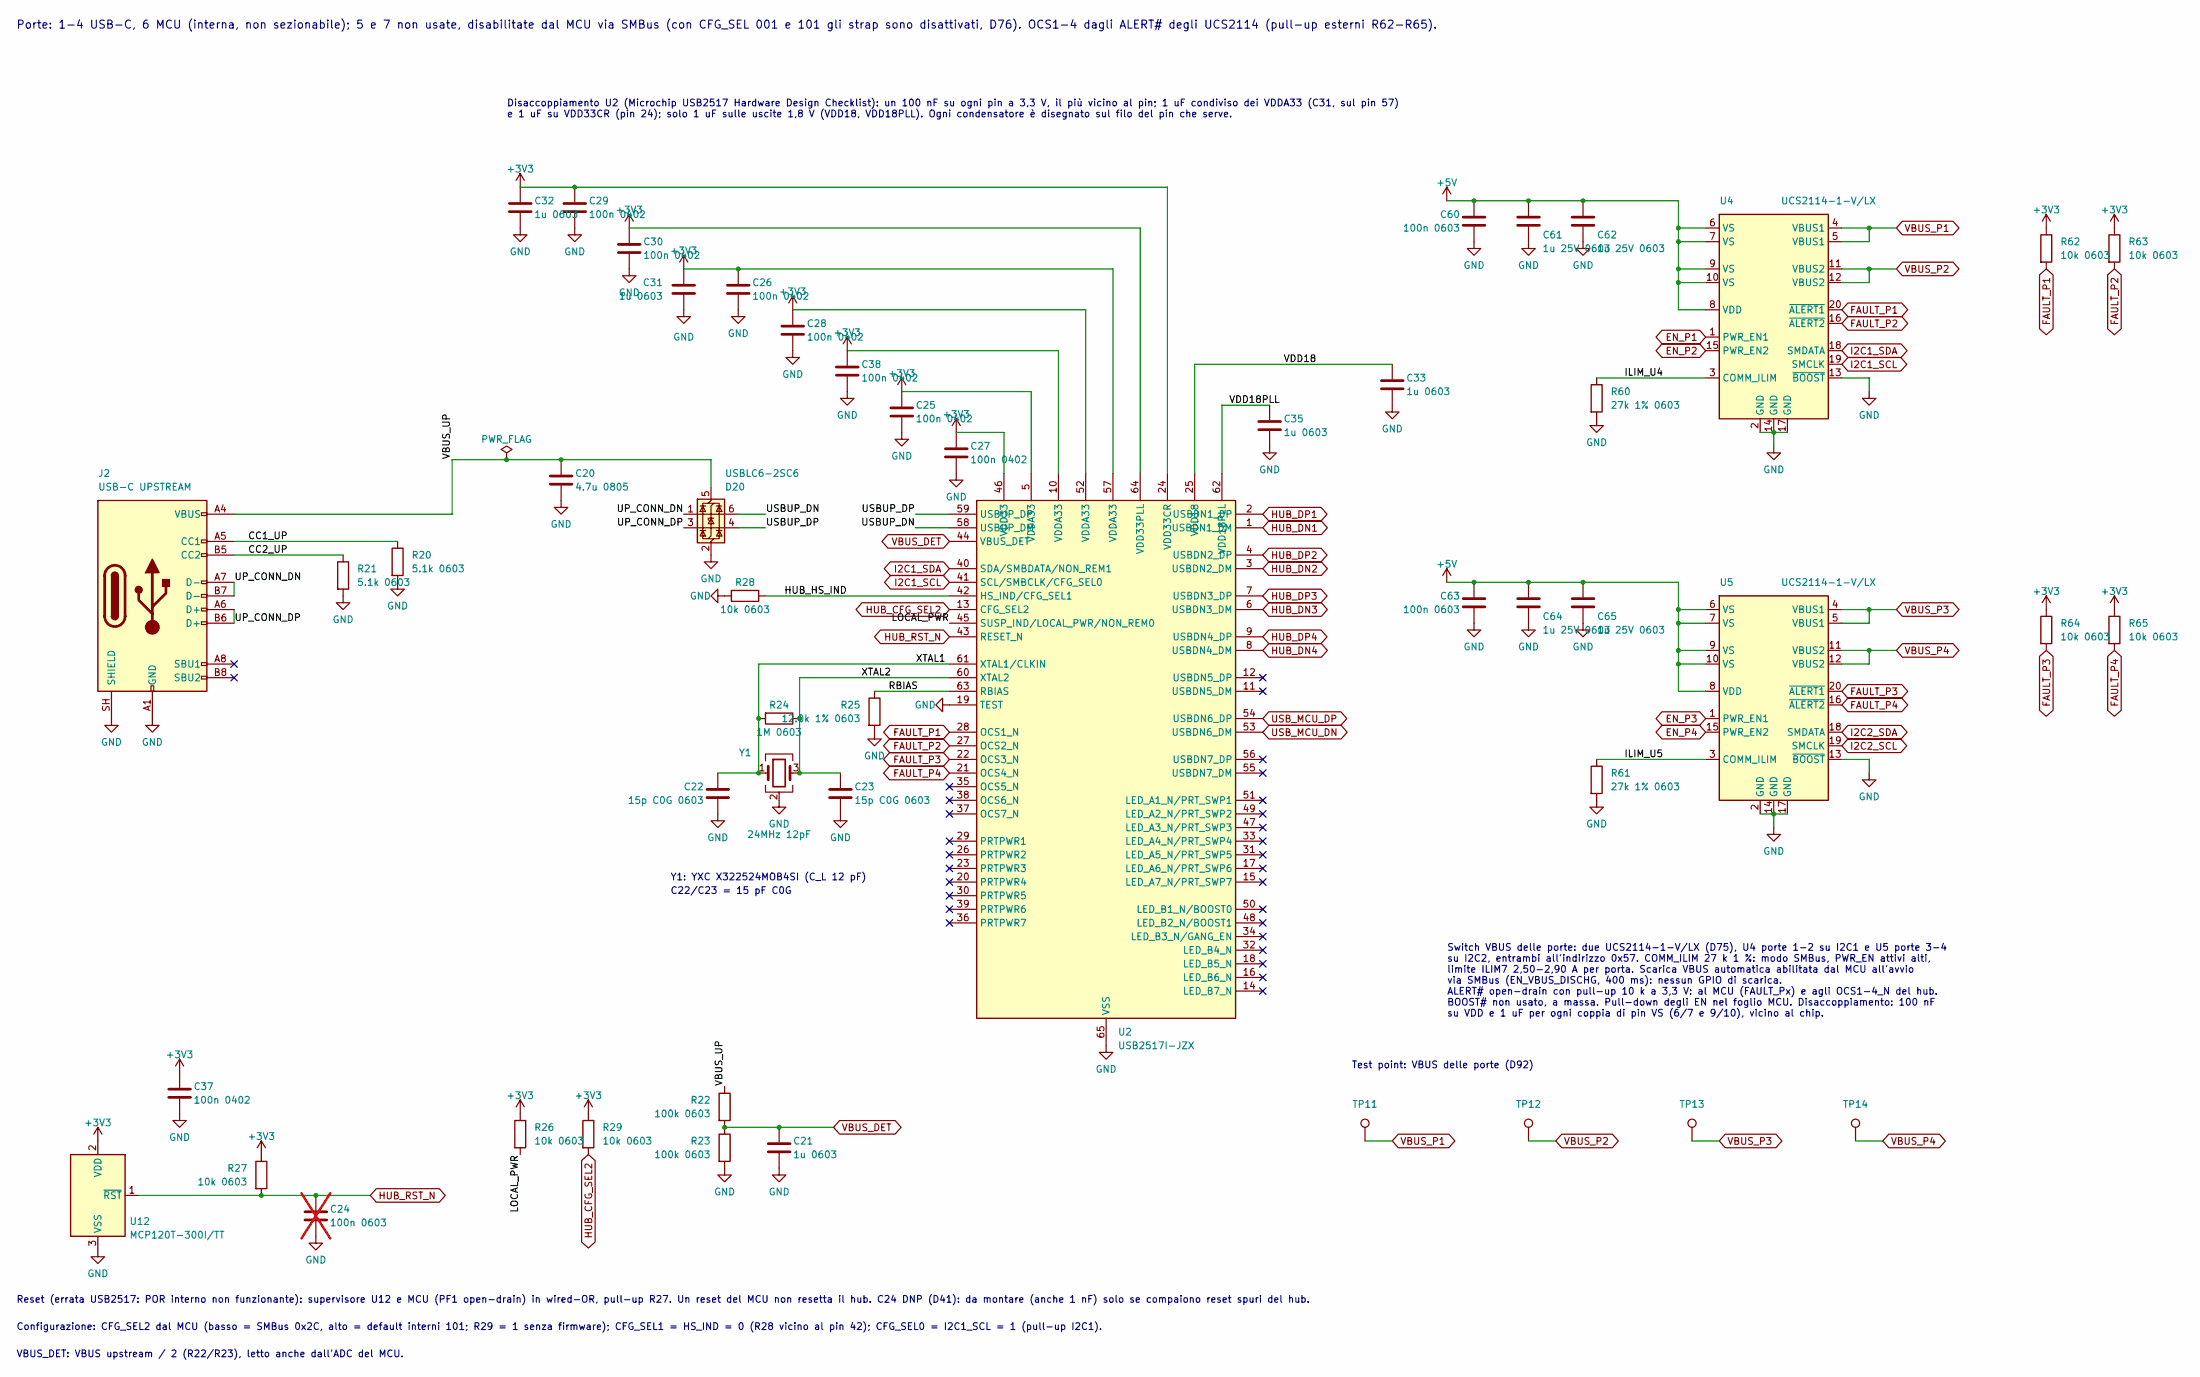
[picture p5: schematic hub.kicad_sch, Hub USB2517, upstream e switch VBUS UCS2114]

Parts:
C20: 4.7u 0805; C_0805_2012Metric; MPN lcsc CL21A475KOFNNNE; lcsc C1746
C21, C31, C32, C33, C35: 1u 0603; C_0603_1608Metric; MPN lcsc CL10B105KA8NNNC; lcsc C29936
C22, C23: 15p C0G 0603; C_0603_1608Metric; MPN lcsc CL10C150JB8NNNC; lcsc C1644
C24: 100n 0603; C_0603_1608Metric; MPN lcsc CL10B104KB8NNNC; lcsc C1591; not fitted
C25, C26, C27, C28, C29, C30, C37, C38: 100n 0402; C_0402_1005Metric; MPN lcsc CC0402KRX7R7BB104; lcsc C60474
C60, C63: 100n 0603; C_0603_1608Metric; MPN lcsc CL10B104KB8NNNC; lcsc C1591
C61, C62, C64, C65: 1u 25V 0603; C_0603_1608Metric; MPN lcsc CL10B105KA8NNNC; lcsc C29936
D20: USBLC6-2SC6; SOT-23-6; MPN lcsc USBLC6-2SC6; lcsc C7519
J2: USB-C UPSTREAM; USB_C_Receptacle_GCT_USB4105-xx-A_16P_TopMnt_Horizontal; MPN lcsc USB4105-GF-A; lcsc C3020560
R20, R21: 5.1k 0603; R_0603_1608Metric; MPN lcsc 0603WAF5101T5E; lcsc C23186
R22, R23: 100k 0603; R_0603_1608Metric; MPN lcsc FRC0603F1003TS; lcsc C2906980
R24: 1M 0603; R_0603_1608Metric; MPN lcsc FRC0603F1004TS; lcsc C2907003
R25: 12.0k 1% 0603; R_0603_1608Metric; MPN lcsc RC0603FR-0712KL; lcsc C114659
R26, R27, R28, R29, R62, R63, R64, R65: 10k 0603; R_0603_1608Metric; MPN lcsc FRC0603F1002TS; lcsc C2906982
R60, R61: 27k 1% 0603; R_0603_1608Metric; MPN lcsc RC0603FR-0727KL; lcsc C114614
TP11: VBUS_P1; TestPoint_Pad_D1.5mm
TP12: VBUS_P2; TestPoint_Pad_D1.5mm
TP13: VBUS_P3; TestPoint_Pad_D1.5mm
TP14: VBUS_P4; TestPoint_Pad_D1.5mm
U2: USB2517I-JZX; QFN-64-1EP_9x9mm_P0.5mm_EP4.7x4.7mm_ThermalVias_0.3mm; MPN lcsc USB2517I-JZX; lcsc C478081
U4, U5: UCS2114-1-V/LX; UCS2114_VQFN-20_3x3mm_P0.5mm; MPN lcsc UCS2114-1-V/LX; lcsc C635426
U12: MCP120T-300I/TT; SOT-23; MPN lcsc MCP120T-300I/TT; lcsc C625180
Y1: 24MHz 12pF; Crystal_SMD_3225-4Pin_3.2x2.5mm; MPN lcsc X322524MOB4SI; lcsc C70590

Connections:
+3V3: C25.1, C26.1, C27.1, C28.1, C29.1, C30.1, C31.1, C32.1, C37.1, C38.1, R26.1, R27.1, R29.1, R62.1, R63.1, R64.1, R65.1, U2.5 (VDDA33), U2.10 (VDDA33), U2.24 (VDD33CR), U2.46 (VDD33), U2.52 (VDDA33), U2.57 (VDDA33), U2.64 (VDD33PLL), U12.2 (VDD); also elsewhere on the board
+5V: C60.1, C61.1, C62.1, C63.1, C64.1, C65.1, U4.6 (VS), U4.7 (VS), U4.8 (VDD), U4.9 (VS), U4.10 (VS), U5.6 (VS), U5.7 (VS), U5.8 (VDD), U5.9 (VS), U5.10 (VS); also elsewhere on the board
/Hub USB e switch VBUS/CC1_UP: J2.A5 (CC1), R20.1
/Hub USB e switch VBUS/CC2_UP: J2.B5 (CC2), R21.1
/Hub USB e switch VBUS/HUB_HS_IND: R28.1, U2.42 (HS_IND/CFG_SEL1)
/Hub USB e switch VBUS/ILIM_U4: R60.1, U4.3 (COMM_ILIM)
/Hub USB e switch VBUS/ILIM_U5: R61.1, U5.3 (COMM_ILIM)
/Hub USB e switch VBUS/LOCAL_PWR: R26.2, U2.45 (SUSP_IND/LOCAL_PWR/NON_REM0)
/Hub USB e switch VBUS/RBIAS: R25.1, U2.63 (RBIAS)
/Hub USB e switch VBUS/UP_CONN_DN: D20.1 (I/O1), J2.A7 (D-), J2.B7 (D-)
/Hub USB e switch VBUS/UP_CONN_DP: D20.3 (I/O2), J2.A6 (D+), J2.B6 (D+)
/Hub USB e switch VBUS/USBUP_DN: D20.6 (I/O1), U2.58 (USBUP_DM)
/Hub USB e switch VBUS/USBUP_DP: D20.4 (I/O2), U2.59 (USBUP_DP)
/Hub USB e switch VBUS/VBUS_UP: C20.1, D20.5 (VBUS), J2.A4 (VBUS), J2.A9 (VBUS), J2.B4 (VBUS), J2.B9 (VBUS), R22.1
/Hub USB e switch VBUS/VDD18: C33.1, U2.25 (VDD18)
/Hub USB e switch VBUS/VDD18PLL: C35.1, U2.62 (VDD18PLL)
/Hub USB e switch VBUS/XTAL1: C22.1, R24.2, U2.61 (XTAL1/CLKIN), Y1.1
/Hub USB e switch VBUS/XTAL2: C23.1, R24.1, U2.60 (XTAL2), Y1.3
EN_P1: U4.1 (PWR_EN1); also elsewhere on the board
EN_P2: U4.15 (PWR_EN2); also elsewhere on the board
EN_P3: U5.1 (PWR_EN1); also elsewhere on the board
EN_P4: U5.15 (PWR_EN2); also elsewhere on the board
FAULT_P1: R62.2, U2.28 (OCS1_N), U4.20 (~ALERT1); also elsewhere on the board
FAULT_P2: R63.2, U2.27 (OCS2_N), U4.16 (~ALERT2); also elsewhere on the board
FAULT_P3: R64.2, U2.22 (OCS3_N), U5.20 (~ALERT1); also elsewhere on the board
FAULT_P4: R65.2, U2.21 (OCS4_N), U5.16 (~ALERT2); also elsewhere on the board
GND: C20.2, C21.2, C22.2, C23.2, C24.2, C25.2, C26.2, C27.2, C28.2, C29.2, C30.2, C31.2, C32.2, C33.2, C35.2, C37.2, C38.2, C60.2, C61.2, C62.2, C63.2, C64.2, C65.2, D20.2 (GND), J2.A1 (GND), J2.A12 (GND), J2.B1 (GND), J2.B12 (GND), J2.SH (SHIELD), R20.2, R21.2, R23.2, R25.2, R28.2, R60.2, R61.2, U2.19 (TEST), U2.65 (VSS), U4.2 (GND), U4.13 (~BOOST), U4.14 (GND), U4.17 (GND), U5.2 (GND), U5.13 (~BOOST), U5.14 (GND), U5.17 (GND), U12.3 (VSS), Y1.2 (G), Y1.4 (G); also elsewhere on the board
HUB_CFG_SEL2: R29.2, U2.13 (CFG_SEL2); also elsewhere on the board
HUB_DN1: U2.1 (USBDN1_DM); also elsewhere on the board
HUB_DN2: U2.3 (USBDN2_DM); also elsewhere on the board
HUB_DN3: U2.6 (USBDN3_DM); also elsewhere on the board
HUB_DN4: U2.8 (USBDN4_DM); also elsewhere on the board
HUB_DP1: U2.2 (USBDN1_DP); also elsewhere on the board
HUB_DP2: U2.4 (USBDN2_DP); also elsewhere on the board
HUB_DP3: U2.7 (USBDN3_DP); also elsewhere on the board
HUB_DP4: U2.9 (USBDN4_DP); also elsewhere on the board
HUB_RST_N: C24.1, R27.2, U2.43 (RESET_N), U12.1 (~RST); also elsewhere on the board
I2C1_SCL: U2.41 (SCL/SMBCLK/CFG_SEL0), U4.19 (SMCLK); also elsewhere on the board
I2C1_SDA: U2.40 (SDA/SMBDATA/NON_REM1), U4.18 (SMDATA); also elsewhere on the board
I2C2_SCL: U5.19 (SMCLK); also elsewhere on the board
I2C2_SDA: U5.18 (SMDATA); also elsewhere on the board
USB_MCU_DN: U2.53 (USBDN6_DM); also elsewhere on the board
USB_MCU_DP: U2.54 (USBDN6_DP); also elsewhere on the board
VBUS_DET: C21.1, R22.2, R23.1, U2.44 (VBUS_DET); also elsewhere on the board
VBUS_P1: TP11.1 (1_1), U4.4 (VBUS1), U4.5 (VBUS1); also elsewhere on the board
VBUS_P2: TP12.1 (1_1), U4.11 (VBUS2), U4.12 (VBUS2); also elsewhere on the board
VBUS_P3: TP13.1 (1_1), U5.4 (VBUS1), U5.5 (VBUS1); also elsewhere on the board
VBUS_P4: TP14.1 (1_1), U5.11 (VBUS2), U5.12 (VBUS2); also elsewhere on the board

Notes on the sheet:
Y1: YXC X322524MOB4SI (C_L 12 pF)
C22/C23 = 15 pF C0G
Test point: VBUS delle porte (D92)
Disaccoppiamento U2 (Microchip USB2517 Hardware Design Checklist): un 100 nF su ogni pin a 3,3 V, il più vicino al pin; 1 uF condiviso dei VDDA33 (C31, sul pin 57) e 1 uF su VDD33CR (pin 24); solo 1 uF sulle uscite 1,8 V (VDD18, VDD18PLL). Ogni condensatore è disegnato sul filo del pin che serve.
VBUS_DET: VBUS upstream / 2 (R22/R23), letto anche dall'ADC del MCU.
Reset (errata USB2517: POR interno non funzionante): supervisore U12 e MCU (PF1 open-drain) in wired-OR, pull-up R27. Un reset del MCU non resetta il hub. C24 DNP (D41): da montare (anche 1 nF) solo se compaiono reset spuri del hub.
Configurazione: CFG_SEL2 dal MCU (basso = SMBus 0x2C, alto = default interni 101; R29 = 1 senza firmware); CFG_SEL1 = HS_IND = 0 (R28 vicino al pin 42); CFG_SEL0 = I2C1_SCL = 1 (pull-up I2C1).
Switch VBUS delle porte: due UCS2114-1-V/LX (D75), U4 porte 1-2 su I2C1 e U5 porte 3-4 su I2C2, entrambi all'indirizzo 0x57. COMM_ILIM 27 k 1 %: modo SMBus, PWR_EN attivi alti, limite ILIM7 2,50-2,90 A per porta. Scarica VBUS automatica abilitata dal MCU all'avvio via SMBus (EN_VBUS_DISCHG, 400 ms)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
Porte: 1-4 USB-C, 6 MCU (interna, non sezionabile); 5 e 7 non usate, disabilitate dal MCU via SMBus (con CFG_SEL 001 e 101 gli strap sono disattivati, D76). OCS1-4 dagli ALERT# degli UCS2114 (pull-up esterni R62-R65).
