mpolci/devhub/hardware/devhub/devhub.kicad_pcb

## KiCad design hardware/devhub/devhub.kicad_pcb (continued)

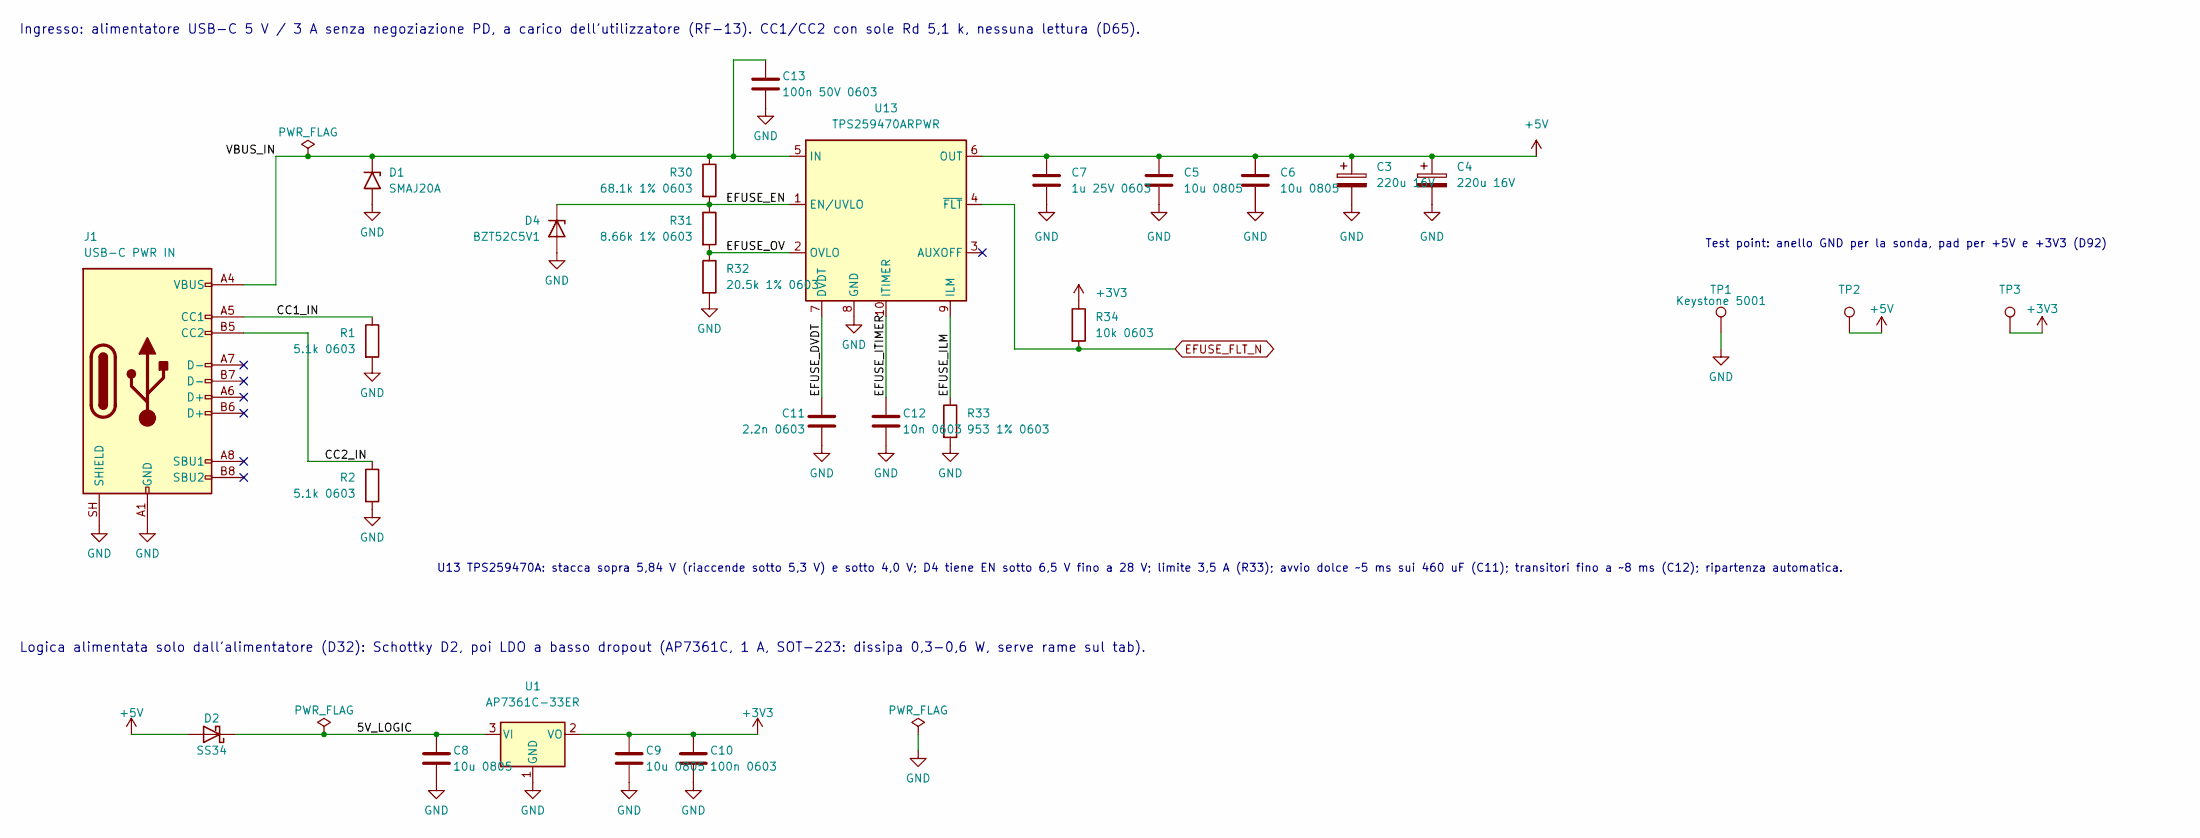
[picture p6: schematic power_in.kicad_sch, Alimentazione: ingresso USB-C 5 V, eFuse e 3,3 V]

Parts:
C3, C4: 220u 16V; CP_Elec_6.3x7.7; MPN lcsc EEE-FK1C221XP; lcsc C128533
C5, C6, C8, C9: 10u 0805; C_0805_2012Metric; MPN lcsc GRM21BR61H106KE43L; lcsc C440198
C7: 1u 25V 0603; C_0603_1608Metric; MPN lcsc CL10B105KA8NNNC; lcsc C29936
C10: 100n 0603; C_0603_1608Metric; MPN lcsc CL10B104KB8NNNC; lcsc C1591
C11: 2.2n 0603; C_0603_1608Metric; MPN lcsc CL10B222KB8NNNC; lcsc C16033
C12: 10n 0603; C_0603_1608Metric; MPN lcsc CL10B103KB8NNNC; lcsc C1589
C13: 100n 50V 0603; C_0603_1608Metric; MPN lcsc CL10B104KB8NNNC; lcsc C1591
D1: SMAJ20A; D_SMA; MPN lcsc SMAJ20A-13-F; lcsc C134969
D2: SS34; D_SMA; MPN lcsc B340A-13-F; lcsc C85098
D4: BZT52C5V1; D_SOD-123; MPN lcsc BZT52C5V1-7-F; lcsc C151588
J1: USB-C PWR IN; USB_C_Receptacle_GCT_USB4105-xx-A_16P_TopMnt_Horizontal; MPN lcsc USB4105-GF-A; lcsc C3020560
R1, R2: 5.1k 0603; R_0603_1608Metric; MPN lcsc 0603WAF5101T5E; lcsc C23186
R30: 68.1k 1% 0603; R_0603_1608Metric; MPN lcsc RC0603FR-0768K1L; lcsc C185315
R31: 8.66k 1% 0603; R_0603_1608Metric; MPN lcsc 0603WAF8661T5E; lcsc C23114
R32: 20.5k 1% 0603; R_0603_1608Metric; MPN lcsc RC0603FR-0720K5L; lcsc C273789
R33: 953 1% 0603; R_0603_1608Metric; MPN lcsc RC0603FR-07953RL; lcsc C137668
R34: 10k 0603; R_0603_1608Metric; MPN lcsc FRC0603F1002TS; lcsc C2906982
TP1: Keystone 5001; TestPoint_Keystone_5000-5004_Miniature; MPN mouser 5001; lcsc C238122
TP2: +5V; TestPoint_Pad_D1.5mm
TP3: +3V3; TestPoint_Pad_D1.5mm
U1: AP7361C-33ER; SOT-223-3_TabPin2; MPN lcsc AP7361C-33ER-13; lcsc C3743528
U13: TPS259470ARPWR; C3662799_VQFN-10_L2_0-W2_0-P0_45-TL; MPN lcsc TPS259470ARPWR; lcsc C3662799

Connections:
+3V3: C9.1, C10.1, R34.1, TP3.1 (1_1), U1.2 (VO); also elsewhere on the board
+5V: C3.1, C4.1, C5.1, C6.1, C7.1, D2.2 (A), TP2.1 (1_1), U13.6 (OUT); also elsewhere on the board
/Alimentazione/5V_LOGIC: C8.1, D2.1 (K), U1.3 (VI)
/Alimentazione/CC1_IN: J1.A5 (CC1), R1.1
/Alimentazione/CC2_IN: J1.B5 (CC2), R2.1
/Alimentazione/EFUSE_DVDT: C11.1, U13.7 (DVDT)
/Alimentazione/EFUSE_EN: D4.1 (K), R30.2, R31.1, U13.1 (EN/UVLO)
/Alimentazione/EFUSE_ILM: R33.1, U13.9 (ILM)
/Alimentazione/EFUSE_ITIMER: C12.1, U13.10 (ITIMER)
/Alimentazione/EFUSE_OV: R31.2, R32.1, U13.2 (OVLO)
/Alimentazione/VBUS_IN: C13.1, D1.1 (K), J1.A4 (VBUS), J1.A9 (VBUS), J1.B4 (VBUS), J1.B9 (VBUS), R30.1, U13.5 (IN)
EFUSE_FLT_N: R34.2, U13.4 (~FLT); also elsewhere on the board
GND: C3.2, C4.2, C5.2, C6.2, C7.2, C8.2, C9.2, C10.2, C11.2, C12.2, C13.2, D1.2 (A), D4.2 (A), J1.A1 (GND), J1.A12 (GND), J1.B1 (GND), J1.B12 (GND), J1.SH (SHIELD), R1.2, R2.2, R32.2, R33.2, TP1.1 (1_1), U1.1 (GND), U13.8 (GND); also elsewhere on the board

Notes on the sheet:
U13 TPS259470A: stacca sopra 5,84 V (riaccende sotto 5,3 V) e sotto 4,0 V; D4 tiene EN sotto 6,5 V fino a 28 V; limite 3,5 A (R33); avvio dolce ~5 ms sui 460 uF (C11); transitori fino a ~8 ms (C12); ripartenza automatica.
Ingresso: alimentatore USB-C 5 V / 3 A senza negoziazione PD, a carico dell'utilizzatore (RF-13). CC1/CC2 con sole Rd 5,1 k, nessuna lettura (D65).
Test point: anello GND per la sonda, pad per +5V e +3V3 (D92)
Logica alimentata solo dall'alimentatore (D32): Schottky D2, poi LDO a basso dropout (AP7361C, 1 A, SOT-223: dissipa 0,3-0,6 W, serve rame sul tab).

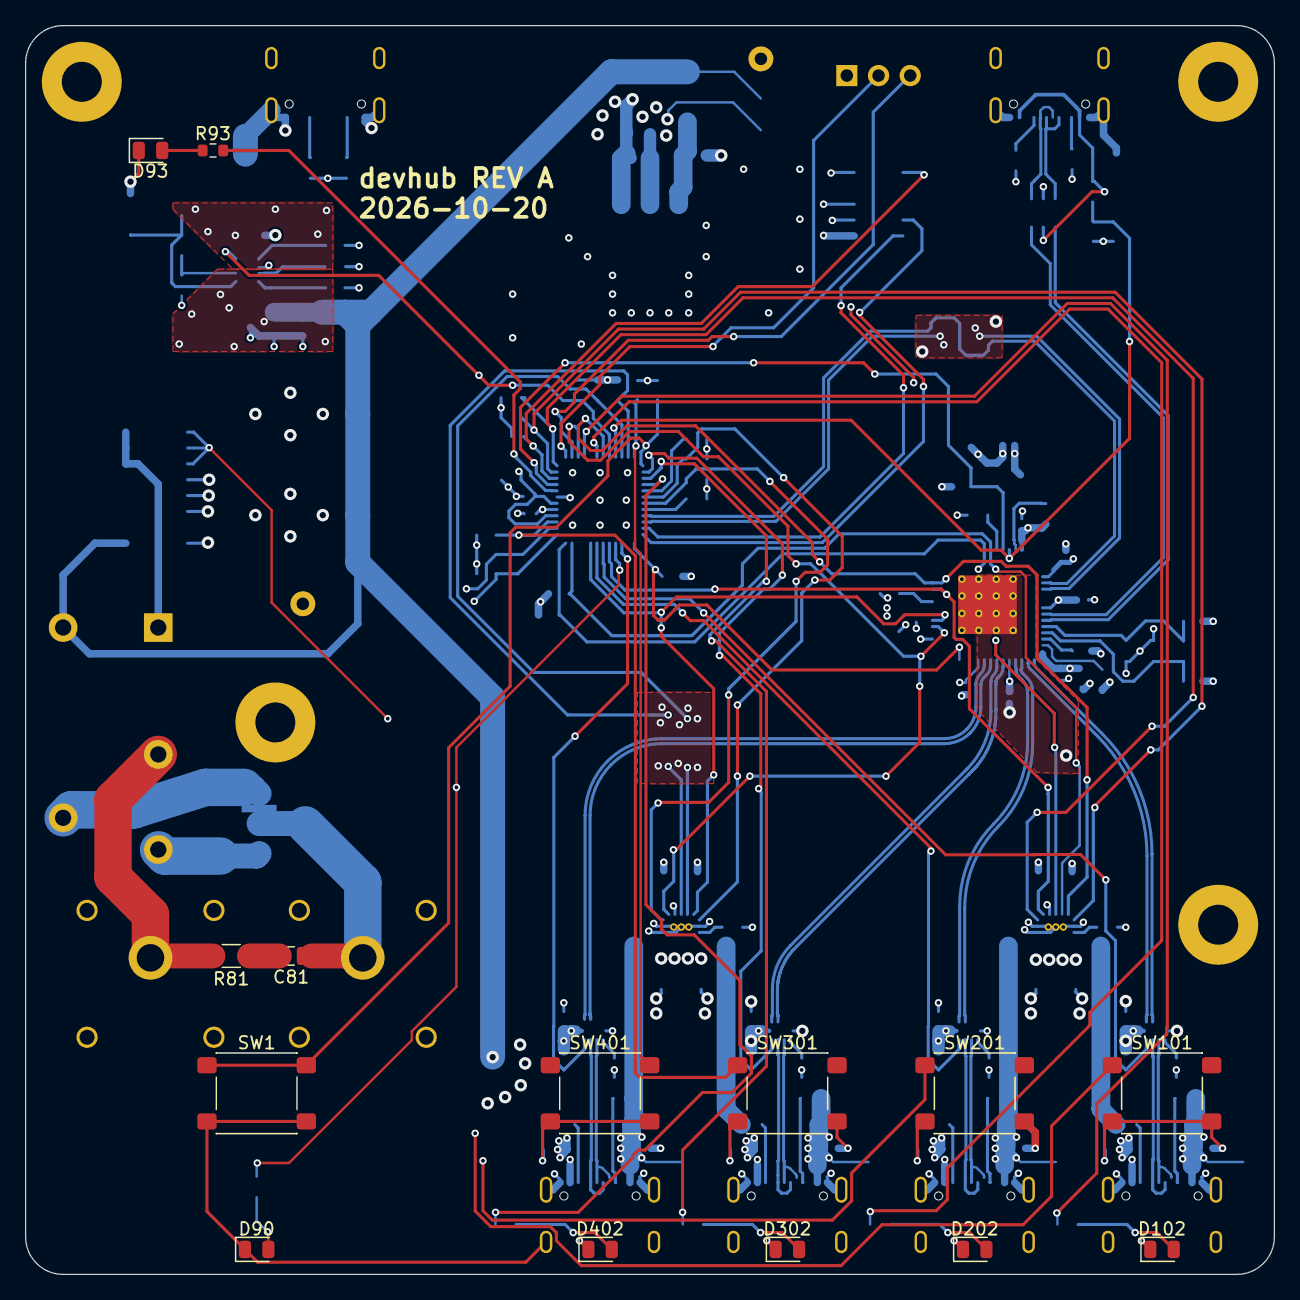
[picture p7: board devhub.kicad_pcb from above]

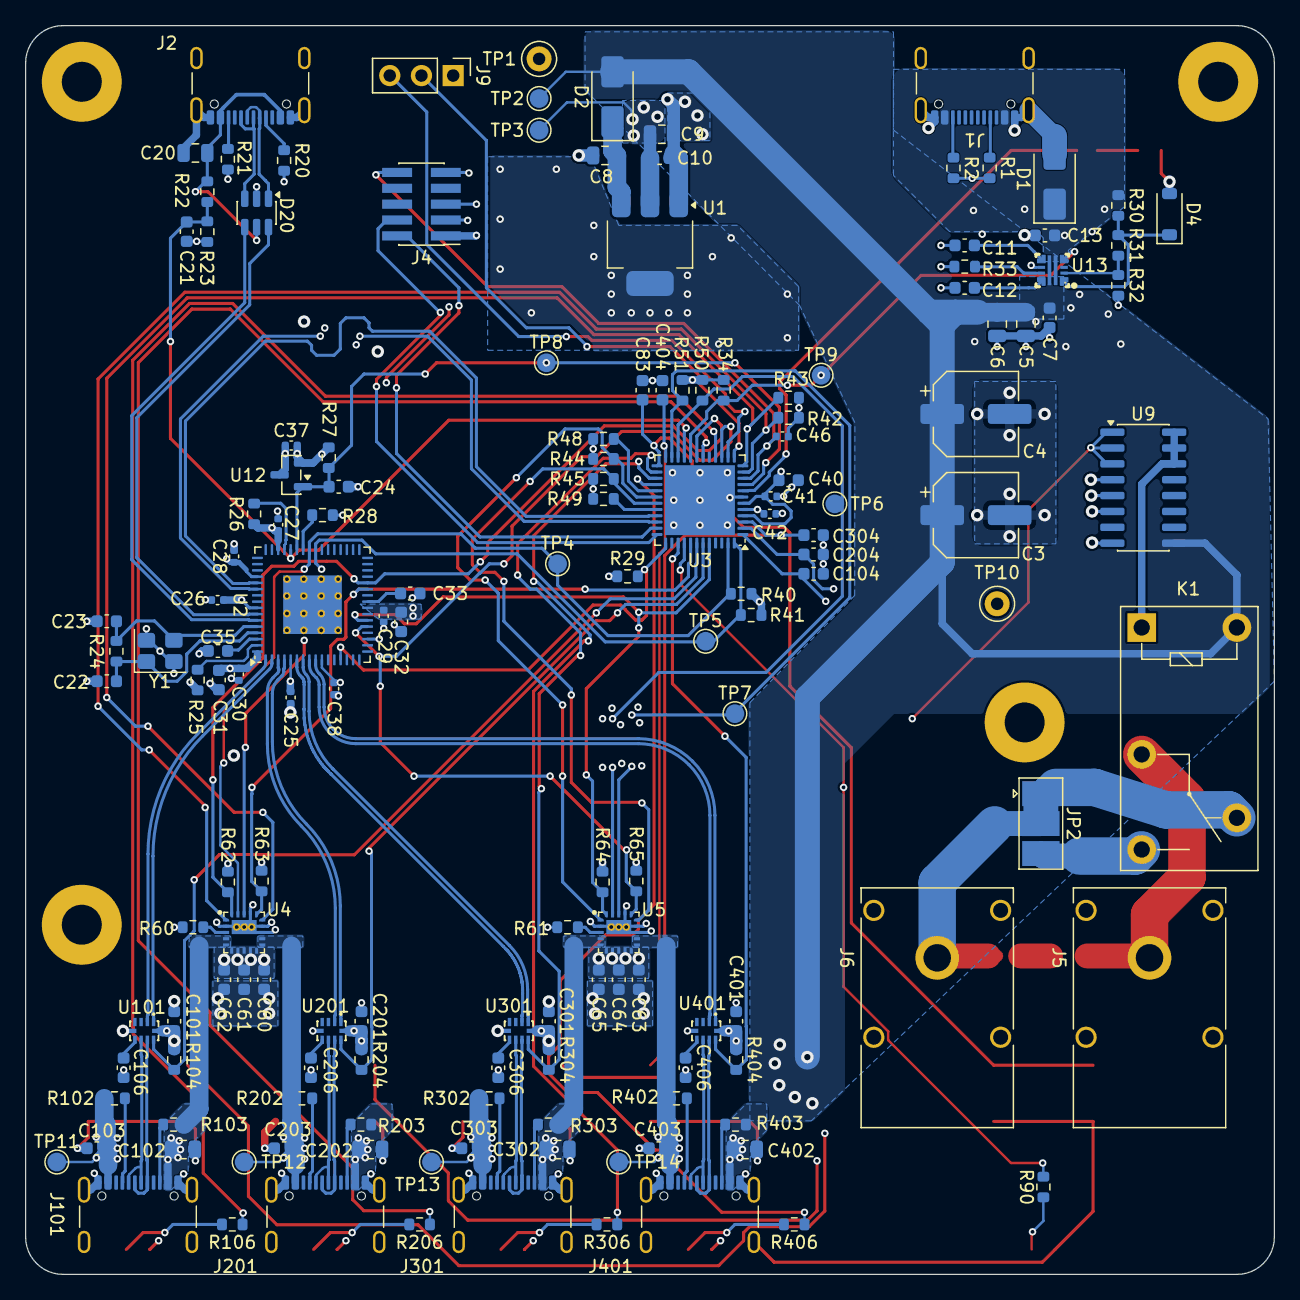
[picture p8: board devhub.kicad_pcb from below]

Board: 4 copper layers, 100.0 x 100.0 mm, 170 parts (152 on the bottom side), 112 nets.

Other parts of the board:
H1, H2, H3, H4: M3; MountingHole_3.2mm_M3_Pad
