mpolci/devhub/firmware/src/build_info.h

// Build identification, generated at every build (cmake/build_info.cmake).
#ifndef BUILD_INFO_H
#define BUILD_INFO_H

#include <stdint.h>

extern const uint32_t fw_build_time; // Unix time (UTC) of the build

#endif
