mpolci/devhub/(commit log)

2026-10-09 Architecture: STM32G0B1 with UCPD, candidate components, hand assembly, 5 V / 3 A power without USB-PD
    - MCU STM32G0B1 with UCPD; candidate components with Mouser/DigiKey
    alternatives per block; TPS2561A as main port load switch.
    - Assembly: everything by hand (hot plate + hot air, stencil for the QFNs
    USB2517 and LM61495).
    - Power: 5 V / 3 A input without USB-PD, total port budget ~2.5 A managed
    by firmware; high-power variant documented, TPSM63610 module dropped as
    too expensive.
    - Relays rated 16 V / 3 A.
2026-10-10 Project decisions: upstream port, relays, licenses, USB IDs, enclosure, hub configuration
    - Upstream on USB-C; host side as a Python library + macOS CLI; supplier
    choice deferred to the end.
    - Relays: COM and NC on the panel (line normally connected), NO on a jumper;
    commands expressed in terms of the line.
    - Licenses: CERN-OHL-W 2.0 for hardware, MIT for software and documentation.
    - VID 0x1209 with a test PID; spare hub port on an internal header.
    - Enclosure: custom 3D-printed box, connectors and banana jacks on the PCB.
    - Hub: FAULT on OCS_N, SMBus configuration, hub reset driven by the MCU
    (POR erratum); datasheets folder excluded from the repository.
2026-10-10 KiCad schematic v0.1: 9 sheets, USB2517 symbol, MCU pinout documented
    The schematic was first generated by script, then the generator scripts
    were removed: from here on it is edited in KiCad only.
    - Port sheets: internal labels (CC, D+/D-, discharge, LED) made local; as
    globals they shorted the same nets of all five port instances.
    - UART connector renamed J9 (clashed with J5), #PWR/#FLG references made
    unique.
    - Relay NC contact at 3 A / 30 V DC accepted without margin.
2026-10-10 Schematic v0.2: hub reset supervisor, 1 A LDO, reorganized sheets, USB connectors and crystal
    Functional changes:
    - USB2517 RESET_N with pull-up and MCP120T-300 supervisor, wired-OR with
    the MCU (open-drain): resetting the MCU no longer resets the hub, so the
    ST DFU bootloader is reachable through it (D16/D17).
    - 3.3 V LDO: AP7361C-33E (1 A, SOT-223) instead of AP2112K, which
    dissipated too much with the hub load.
    - 74HC595 /OE on PB6 with pull-up: LEDs off until firmware enables them.
    - Orange D93 instead of blue, USB-A bulk capacitance >= 120 uF, relay coil
    pinout fixed, snubbers marked DNP, Cliff FCR7350 banana jack footprints.
    - D18: horizontal USB connectors, GCT USB4105-GF-A (U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
2026-10-10 Lab-use protection: TPS259470A input eFuse, PI3USB4002A data switches; AGENTS.md
    Power input (D20, D21):
    - TPS259470A eFuse after the shunt: trips above 5.84 V and below 4.0 V,
    zener on EN to withstand up to 28 V, 3.5 A limit, ~5 ms soft start,
    auto-retry, FLT to the MCU on PB1.
    - The shunt stays before the eFuse, so the INA3221 still measures the input
    voltage when the eFuse is off.
    Ports (D22): PI3USB4002A instead of TS3USB30E. The connector side withstands
    24 V and opens above 4.75 V, so a D+/D- short to VBUS on a board under test
    no longer reaches the 3.3 V rail.
    Symbols for both ICs added to the project library. AGENTS.md added: the
    schematic is edited in KiCad or with targeted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
2026-10-10 SMAJ20A input TVS, no TVS on ports (D24, D25); relay push buttons (D26)
    - The SMAJ5.0A already conducted at ~6.4 V and would burn with a 12-20 V
    supply before the eFuse trips; the SMAJ20A lets the eFuse do its job.
    No TVS on ports: it does not help against a sustained back-fed voltage.
    Two LEDs per port confirmed.
    - SW1/SW2 on PB12/PB13 toggle the relays; new requirement RF-17 on panel
    buttons, RELAY_CHANGED event in the protocol.
    Targeted schematic changes, connectivity otherwise unchanged, ERC clean.
2026-10-10 Review 02, R02-01: remove USBLC6 from downstream ports (D27)
    Adds the electrical review 02 document.
    The USBLC6 VBUS pin sat on the switched port VBUS: its internal diodes fed
    current from the data lines into the supply (an "off" port at ~2.6 V with a
    self-powered board) and routed data overvoltage to 5 V, bypassing the 24 V
    tolerance of the PI3USB4002A. Downstream ESD protection is now the one
    integrated in the switch (10 kV IEC); the upstream port keeps its USBLC6.
    Connectivity checked, ERC clean.
2026-10-10 RF-3: port power and data always switched together, in sequence (D28)
    Protocol and CLI no longer have separate power/data commands.
2026-10-10 Review 02, R02-02: no insertion detection on USB-C ports (D29)
    Checks are done by firmware, signalled with the red LED and a warning.
2026-10-11 Review 02, R02-03: USB-C ports advertise default USB current (Rp 56 k, D30)
    RF-5 now distinguishes the advertised current from the hardware limit.
2026-10-11 Review 02, R02-04: document the real limits of the input chain (D31)
    Protection is guaranteed up to 20 V.
2026-10-12 Review 02, R02-05: drop RF-16, logic powered from the supply only (D32)
    Removed D3; VBUS_DET and VSYS_ADC moved to 5 V tolerant pins (PA6, PA7).
2026-10-12 Review 02, R02-06: ULN2003V12 relay driver, three channels in parallel per relay (D33)
2026-10-12 Review 02, R02-09: current measurement accuracy specified in RF-6 (D36)
    Offset is zeroed while the port is off.
2026-10-12 Review 02, R02-10: VBUS discharge down to a measured 0.8 V with timeout (D37)
    off_ms is counted from the moment VBUS is off. Cosmetic schematic cleanup.
2026-10-12 Simplification: drop the 74HC595s, green LEDs on port EN, relay LEDs on relay commands (D38)
    Red port LEDs and the host LED are driven by GPIOs that stay low in DFU; the power LED is on 3.3 V.
2026-10-12 Simplification: input shunt moved after the eFuse, VSYS_ADC divider removed (D40)
    The INA3221 is no longer exposed to the supply voltage and reads 5V_SYS; LOCAL_PWR gets a 10k pull-up (R26). Push-button capacitors kept (D39).
2026-10-12 Simplification: hub reset capacitor C24 set to DNP (D41)
    The MCP120 generates the reset delay internally; the pad stays in case spurious hub resets show up.
2026-10-12 Intial PCB layout
2026-10-12 PCB rules in KiCad, USB pair names, eFuse output bypass and U2 thermal vias (D44-D50)
    Stackup JLC04161H-7628, netclasses and custom DRC rules (devhub.kicad_dru) from
    docs/regole-pcb.md, with a section for the checks that DRC cannot cover. C7 1 uF on
    the TPS259470A output before the shunt (D48). USB nets renamed to DP/DN so KiCad
    recognizes the differential pairs (D49). U2 footprint with 0.3 mm thermal vias, open
    on both sides for the prototype; encroached vias and a JLCPCB order note for
    production (D50). Also includes stock part codes, cost comparison and placement rules
    (D44-D47).
2026-10-12 Review 03 fixes and PCB placement update (D51-D56)
    Schematic review 03 (docs/lavorazioni/review_03.md):
    - D1 SMAJ20A was reversed (cathode on GND): rotated, and replaced by a project
    symbol devhub:SMAJ20A with explicit K/A pin names; breakdown corrected to
    22.2-24.5 V (R03-01).
    - D21 BAT54WS from VBUS_DET to 3V3 keeps USB2517 pin 44 within VDD33 + 0.5 V
    when the hub is unpowered (D53, R03-02).
    - USB-A port limited to 1.5 A, the J501 connector rating: R62 33.2k, RF-5
    updated (D54, R03-03).
    - RF-6 accuracy relaxed to 2 mA + 5 % because of the thick-film shunt TCR
    (D55, R03-04).
    - Courtyards of the LCSC U13 and PI3USB4002A footprints enlarged to cover the
    pads, also in the PCB copie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
2026-10-13 MCU and hub decoupling, USB2517 checklist, VBUS_DET without clamp diode (D53, D57, D58)
    - MCU U3 decoupling per DS13560 fig. 15: C41 100 nF + C40 4.7 uF on VDD/VSS,
    C42 100 nF on VREF+; C43, C44 and C45 removed (D57).
    - Hub U2 decoupling per the Microchip USB2517 Hardware Design Checklist: 100 nF on
    each 3.3 V pin (C38 added), 1 uF shared by VDDA33 (C31) and on VDD33CR, only 1 uF
    on VDD18 and VDD18PLL (C34, C36 removed). Each capacitor drawn on its pin's wire.
    The 100 nF of U2 and U12 are 0402 (stock ID 217) to fit next to the pins between
    the USB pairs; DRC exception for the +3V3 stubs inside the U2_DECAP areas (D58).
    - VBUS_DET: D21 removed, plain 100k/100k divider as recommended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
2026-10-13 wip pcb
2026-10-14 Documenta i requisiti semplificati di devhub (D60-D65)
    Elimina misure di corrente/tensione e gestione del budget; definisce il ciclo
    temporizzato con scarica attiva, la sequenza interna del controller, un LED
    per porta e l'alimentatore richiesto 5 V / 3 A senza verifica CC.
    Allinea protocollo e architettura, distinguendo i requisiti correnti dallo
    schema/PCB ancora da adeguare. Nessuna modifica ai file KiCad.
2026-10-14 Schematic v0.3: apply simplified requirements (D79-D81)
    Update the existing KiCad project instead of starting over:
    - MCU U3 replaced with STM32G0B1CEU6 (UFQFPN48) on the 48-pin pinout
    - switches sheet: two UCS2114-1-V/LX on separate I2C buses replace
    TPS2561A, INA3221 and current shunts
    - ports: single MCU-driven LED, discrete VBUS discharge removed
    - remove USB-A port, spare hub header, second relay channel,
    input CC ADC filters and input shunt
    - add UCS2114 symbol and footprint (Microchip land pattern C04-2421)
    - align pinout, decisions, architecture and component docs
2026-10-14 Schematic: keep only host system LED, merge VBUS switches into hub sheet (D82, D83)
    - remove relay LED (D90/R90) and power LED (D92/R92)
    - move UCS2114 VBUS switches into the hub sheet, renamed to
    "Hub USB e switch VBUS"
    - move the host LED into the MCU sheet as a local net
    - drop the switches and ui sheets; update netclass patterns and docs
2026-10-14 PCB: 100x100 mm outline and initial placement (D84)
    - 100x100 mm R3 outline; front: banana jacks at u=10/27, USB-C at
    u=46/61/76/91 (15 mm pitch); M3 holes moved off the front corners
    - remove obsolete v0.2 footprints, all tracks, TPS2561A zones,
    second relay keepout and the In1 +3V3 plane; GND_In2 resized
    - move functional groups rigidly with their rule areas; place the
    UCS2114 support parts, R50/R51 and the host LED
    - UCS2114 footprint: 3 thermal vias 0.6/0.3 mm (annular ring >= 0.15)
    - DRC rules: new hub sheet net name, single relay channel
    - update PCB rules, hardware README, architecture and decisions
2026-10-14 PCB: reuse v0.2 routing where relative placement is unchanged
    - import v0.2 tracks and vias per functional group with the same
    translation (ports, hub, upstream, power), renaming changed nets
    - drop items whose pads changed net (EN to LED resistors), old
    TPS2561A-area routing, USB_MCU fragments and stray stubs
    - remove the stale F.Cu GND zone, restrict GND_In2 to In2.Cu, restore
    the In1 +3V3 plane and the VBUS islands used by the imported vias
    - update PCB notes in hardware/README.md and regole-pcb.md
2026-10-14 PCB rules: GND plane on In2.Cu, +3V3 plane on In1.Cu
2026-10-14 PCB: make port 1 layout identical to ports 2-4
    C103, C106 and R102 moved to the same position relative to J101 as in
    the other ports; port 1 local routing replaced with a copy of port 2
    shifted by 15 mm (VBUS branch towards the UCS2114 left to route).
2026-10-14 Power stage: lower eFuse OVLO, SMD bulk caps, move button row (D85-D87)
    - R30/R31 68.1k/8.66k: OVLO 5.52-5.90 V, below the 6 V abs max of UCS2114
    - C3/C4 Panasonic EEE-FK1C221XP SMD 220 uF 16 V replace THT radials
    - Buttons at v = 14.5 mm from the front edge
    - Update power budget and LDO dissipation for four ports
2026-10-14 MCU 100 nF caps in 0402, U2/U3 fanout rule areas (D88)
    - C41, C42, C46 to C_0402_1005Metric, warehouse ID 217 (CC0402KRX7R7BB104)
    - Single U2_FANOUT and new U3_FANOUT rule areas for USB clearance exceptions
    - Zone defaults: 1 mm corner radius, 0.1 mm min clearance
    - Fix MCU pin numbers in D57 (UFQFPN48)
2026-10-15 Restore relay LED, larger NC/NO jumper, PCB routing progress (D89, D90)
    - D90/R90 relay LED back on RLY1, in the front LED row in line with SW1;
    host LED D93/R93 moved to the rear next to J1
    - JP2: project footprint with 2.0x3.0 mm pads, 2.4 mm pitch and 1.0 mm
    bridge for 3 A relay contacts
    - U13: 0.2 mm tracks from pads 8/9 alongside the corner pads, no clearance
    exception
    - Routing and placement progress, zone defaults, schematic layout cleanup
2026-10-15 PCB routing complete, package in values, MPN fields
    - Routing finished; ESD_FANOUT rule area for D20 centre pins
    - Vias keep inner-layer rings only where connected; GND reference vias
    next to SWD and I2C layer changes
    - Value field of chip R/C/LED includes the package (0402...1206)
    - New fields MPN lcsc, MPN mouser, MPN digikey; LCSC codes for R60/R61,
    U3, U4/U5 and supplier codes completed; JP2 marked DNP on the PCB
2026-10-15 D4: use Vishay BZT52C5V1-G3-18 for Mouser and DigiKey
    BZT52C5V1-7-F stays the LCSC part; same 5.1 V SOD-123 footprint.
2026-10-15 U1: switch to AP7361C-33ER (SOT-223R) for Mouser availability (D91)
    - Project symbol devhub:AP7361C-33ER: pin 1 GND, pin 2 and tab OUT, pin 3 IN
    - U1 supplier codes: LCSC C3743528, Mouser 621-AP7361C-33ER-13, DigiKey AP7361C-33ER-13DICT-ND
    - PCB updated for the reversed pinout; U1_HEATSINK on +3V3
    - Docs aligned: components, costs, architecture, PCB rules, decision D91
2026-10-16 Test points, LED host moved, board finished (D92)
    - 14 test points: GND loops TP1/TP10 (Keystone 5001), pads for +5V, +3V3,
    I2C1/I2C2, HUB_RST_N, EFUSE_FLT_N and VBUS_P1-P4
    - D93/R93 moved to the rear, left of J1
    - Button symbols: generic Value, function in Description; PCB aligned
    - Docs: decision D92, components, PCB test rules, LED host position
2026-10-19 Bigger vias for power and gnd Lines
2026-10-19 +5V copper zones on B.Cu and In1.Cu to lower the U13 to U4/U5 resistance
    Replace the 2 mm +5V trunk with a B.Cu zone from U13 and an In1.Cu zone
    along the front edge, including the risers to U4 and U5. Simulated DC
    resistance from U13 to U4 drops from 48.8 to 13.8 mOhm, to U5 from 32.3
    to 9.0 mOhm (41 and 27 mV at 3 A).
2026-10-19 U1 thermal vias, wider input zones, GND links at USB-C pins
    - U1_HEATSINK: zone reshaped to about 2.6 cm2, 11 vias 0.6/0.3 around
    the tab to the +3V3 plane on In1.Cu instead of 4 vias at the zone edges
    - VBUS_IN zone on B.Cu enlarged towards U13, +5V zone corner adjusted
    - Port connectors: GND pins tied to the nearby shield pads with 0.6 mm tracks
    - C5/C6/C7: GND pads joined with 0.6 mm tracks
2026-10-19 Docs: +5V on In1.Cu as accepted deviation (D93), U1 tab and PCB state
    - D93: +5V towards U4/U5 on an In1.Cu zone instead of the outer layers,
    with the simulated copper drops
    - architettura.md: U1 tab is OUT (+3V3) after D91, vias go to the +3V3 plane
    - regole-pcb.md, hardware/README.md: routing and zones are complete,
    describe the current planes and power zones
    - PCB routed, drop completed open item
2026-10-20 PCB release check: USB_MCU jump on In1.Cu, parity fixes, docs aligned (D94, D95)
    PCB: move the USB_MCU_DP crossover jump from In2.Cu to In1.Cu so the GND
    plane stays continuous, tune USB_MCU_DN length to pass the skew rule,
    remove the leftover "Check LDO pad connection" silkscreen note and update
    footprint fields/attributes from the schematic (parity now clean).
    Docs: D94 (slow signals and Full-Speed jump on In1.Cu), D95 (H1 hole
    position), D52 and D84 marked as superseded on those points; layer table,
    port 6 paragraph and manual checks in regole-pcb.md; PCB status, D93 LED
    and H1 position in README.md and hardware/README.md.
2026-11-10 PCB Assembly
2026-11-10 Docs: firmware decisions (D96-D101), HID protocol binary layout 0.1, firmware implementation plan
    Record firmware stack, diagnostic console, fault/warning handling, button and host-absence behaviour. Define report format, status codes and field layout of the control protocol. Align requirements, architecture, MCU pinout notes and READMEs with the assembled prototype. Add the firmware implementation plan as a working document in docs/lavorazioni.
2026-11-10 Firmware: project skeleton, board support, drivers, port logic, HID protocol
    CMake project for STM32G0B1CEU6 with STM32CubeG0 HAL and TinyUSB as submodules (D96).
    - board: safe GPIO start-up, HSI48/CRS clock for USB, watchdog, reset cause
    - drivers: I2C buses, console UART, UCS2114 port controller, USB2517 hub SMBus download, CRC-protected flash record
    - app: port state machine (staggered power-on, timed cycles, fault latch, warnings), relay, buttons, hub reset sequencing and supervision, power-on defaults, deferred reboot/bootloader/hub reset
    - proto: control protocol 0.1 dispatcher and outgoing report queue
    - usb: composite HID (vendor reports) + CDC console
    - console: diagnostic commands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
2026-11-10 Host: Python library and CLI for control protocol 0.1; READMEs and plan status
    - host/devhub: protocol encoding/decoding, Devhub class over hidapi with event queue, CLI (info, status, port, all, relay, defaults, hub, watch, reboot, bootloader)
    - host/tests: protocol and library tests against a fake transport; opt-in tests on a real device (pytest -m board)
    - firmware and host READMEs: build, flashing, console commands, usage
    - implementation plan: current state and first bench checks
2026-11-10 Firmware: clean restart after bootloader jump, bring-up diagnostics; first results on the prototype
    - system: clear the flash-empty flag and force a clean reset when started by the ROM bootloader's leave jump (stale vector table, interrupts and clocks left the first build without USB)
    - hub_ctrl: let the ports start if HUB_RST_N never rises
    - console: io (GPIO registers), pin (pull-up/pull-down float test), i2c scan
    - board: slower ADC clock for the high-impedance VBUS_DET divider
    - docs: bring-up results on Rev A and hardware anomalies found (floating PB0, PB1, PB11)
2026-11-10 Firmware: fixes from code review
    - flash_store: select the flash bank with FLASH_BANK_NB (512 kB parts are always dual-bank), clear stale error flags before erasing
    - board: configure the ADC channel once and wait for CCRDY; release relay and data switches in the HardFault handler
    - linker: keep .noinit at the top of RAM, outside the 16 kB used by the ROM bootloader
    - proto: events never fill the whole report queue, so a response always fits
    - hub_ctrl: watch HUB_RST_N during the SMBus download; do not block port start-up if SCL is stuck low
    - portctl: discard ALERT# edges latched before the controllers are configured; report the first thermal threshold as over-temperature
    - i2c_bus: clock o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
2026-11-10 Docs: bring-up results after MCU rework; host: clearer error when the device is busy
    PB0 and PB1 fixed by reworking U3; all board tests pass with the reviewed firmware. I2C2_SDA (PB11) still floating: port controller U5 unreachable.
2026-11-10 Console: retained boot log and fault detail; docs: second port controller reachable after rework
    - console: keep the last 4 kB of log lines, 'log' command replays them
    - portctl: log the ALERT# mask and raw interrupt status when a fault is serviced
    - plan: I2C2_SDA fixed, U5 configured; open point on ports 1-2 faulting at power-on
2026-11-10 Ports: measure the start-up stagger from the actual first turn-on
    The controller set-up before the first turn-on made the second port come up 70 ms after the first instead of 100 ms. Plan: power-on fault of ports 1-2 not reproduced.
2026-11-10 Buttons: lockout between presses of the same button; plan: port controller findings after rework
2026-11-10 Plan: port controller solder faults fixed, all four ports switching
2026-11-10 Console: pin test detects weak external pull-ups
2026-11-11 Docs: align status with the bring-up results
    - Plan: status per increment, solder fault table, VBUS_DET checked
    against a multimeter, SWD probe detection recorded
    - READMEs: prototype working, remaining instrument measurements,
    Rev A production files, how to run the devhub command from the venv
    - Architecture, pinout, open questions: DFU, MCU reset and I2C buses
    verified on the prototype
2026-11-11 Host CLI: short guide without arguments, detailed guide with help
    devhub with no arguments (or -h) prints the commands with a one-line
    summary and a few examples; devhub help prints the full guide and
    devhub help <command> the details of one command. Both come from the
    same command table.
2026-11-11 Host: show the device attached to each port in status
    The devhub's USB hub has the same serial number as the control device,
    so the library finds it in the system USB tree (ioreg on macOS, sysfs on
    Linux) and reports the devices on hub ports 1-4: names, VID:PID, serial,
    speed and serial ports. status prints them next to each port and adds a
    device field to the JSON output; attached_devices() exposes them to
    scripts. Verified on the prototype with a USB stick on port 2 and an
    ESP32 board with USB serial on port 3.
2026-11-11 MCU temperature in status, console and CLI (D102)
    The firmware reads the STM32G0B1 internal temperature sensor with its
    factory calibration, corrected through VREFINT for the actual supply,
    and appends it to the GET_STATUS response (-128 if the reading fails).
    The console status prints it; the library exposes Status.mcu_temp_c and
    devhub status shows it. Protocol layout changed in place, still 0.1.
    AGENTS.md: ask before creating new versions or compatibility code.
2026-11-11 Port current and accumulated charge from the port controllers (D103)
    The firmware reads each port's current and delivered charge from the
    UCS2114 registers; charge rationing is enabled in Ignore mode with the
    maximum threshold so the controllers count the charge without acting
    on it. GET_STATUS carries current (mA) and charge (uAh) for every port,
    RESET_CHARGE restarts a port's count, and a charge reset mask kept with
    the defaults restarts it at every turn-on. Console, library and CLI
    expose all of it. Protocol layout changed in place, still 0.1.
    Host: ioreg output is cleaned of control characters before parsing (a
    probe with a binary serial number broke it), and a failure of the
    attached d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
2026-11-11 Host CLI: port on/cycle --wait for the device to enumerate
    With --wait, 'port <n> on' and 'port <n> cycle' return when a device is
    enumerated on the port and print it with its serial ports, or fail after
    --timeout seconds. After a cycle the old enumeration is ignored: attached
    devices now carry the per-enumeration id (macOS sessionID, Linux devnum).
2026-11-11 Host CLI: choose a port by its attached device, find command
    'devhub find <text>' lists the ports whose device matches the text on
    manufacturer, product, serial number, VID:PID or serial port name;
    '@text' in place of a port number chooses the port the same way and must
    match exactly one port.
2026-11-11 Host CLI: log command, port currents as CSV
    'devhub log' reads the status at a fixed interval (default 1 s, minimum
    50 ms) and prints temperature and, for every port, state, current and
    charge as CSV lines, until Ctrl-C or for --duration seconds.
2026-11-11 Firmware build time in GET_INFO, console and devhub info
    Every build writes the build time (Unix, UTC) into a generated source;
    GET_INFO carries it after the serial number, the console 'version' and
    'devhub info' print it as a UTC date. With the version unchanged during
    development, it tells which firmware is on the board.
2026-11-11 Board tests for temperature, build time, measurements, labels and --wait
    The tests on the connected devhub now also check temperature and build
    time, current and charge on every port, the charge reset by command and
    at turn-on, port labels, and that 'port cycle --wait' returns with a new
    enumeration when a device is attached. Settings are restored and never
    saved to flash.
2026-11-11 Per-port current limits in the port controllers (D104)
    The current limit of each port can be lowered below the 2.67 A set by
    the board, to the UCS2114 steps from 0.53 A, through register 14h. The
    limits and the current the power supply can deliver are settings kept in
    flash with the defaults; the firmware applies the limits when it
    configures the controllers and at every change (GET_LIMITS,
    SET_PORT_LIMIT, SET_SUPPLY_LIMIT, console 'limit'). 'devhub limit' sets
    them and compares the worst case, the sum of the limits plus the
    internal consumption, with the supply.
2026-11-11 Port limits: tolerate short peaks in Constant Current mode (D104)
    Limits up to 1.28 A keep the port controller in Constant Current mode
    with its hard ceiling at the next step; the firmware polls CC_MODE every
    20 ms and switches a port off, latched with the new cause current_limit,
    when it stays in current limiting longer than its tolerance (20-10000
    ms, factory 100 ms). Peaks at turn-on or when a device is plugged into a
    port already on go through. Limits from 1.6 A use Trip mode. VBUS under
    the minimum on a port limited in Constant Current mode is a fault, not
    a warning. Verified on the prototype with an ESP32 at 0.53 A and a
    1.3 A load at 0.96 A, also plugged in hot.
2026-11-11 Total current control against the power supply (D105)
    Every 20 ms the firmware adds up the port currents and the internal
    consumption; when the total stays above the declared power supply for
    50 ms it lowers the limit of the port drawing most to the step that
    brings the total back, keeping the port on with the warning budget and
    exempt from the limiting tolerance, so a device that adapts keeps
    working. The LED of a reduced port goes off for 100 ms every second,
    distinct from the fault blink. A port already at the lowest step is
    switched off and latched with cause budget. The lowered limit lasts
    until the port is switched on again or its limit is set; GET_LIMITS
    reports the limits in force. V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
2026-11-12 Docs: open questions for host tools on Linux and Windows and the next board revision. Clarify power consumption precision
2026-11-13 Agent skill to control the devhub from an AI agent (D106)
    Skill sources in host/skill-devhub, installed by symlinking the folder to
    ~/.claude/skills/devhub. The skill describes how the device behaves and leaves
    the choice of when to use it to the agent: finding the CLI and the Python
    library, what may be done without asking, choosing the port, port switching and
    power cycle with wait for the new enumeration, the relay line, faults and
    warnings, reading the state. Command details stay in `devhub help`.
